murilo999-666/impressora-braille/cad/saida/mesas_250x250/mesa_2.png

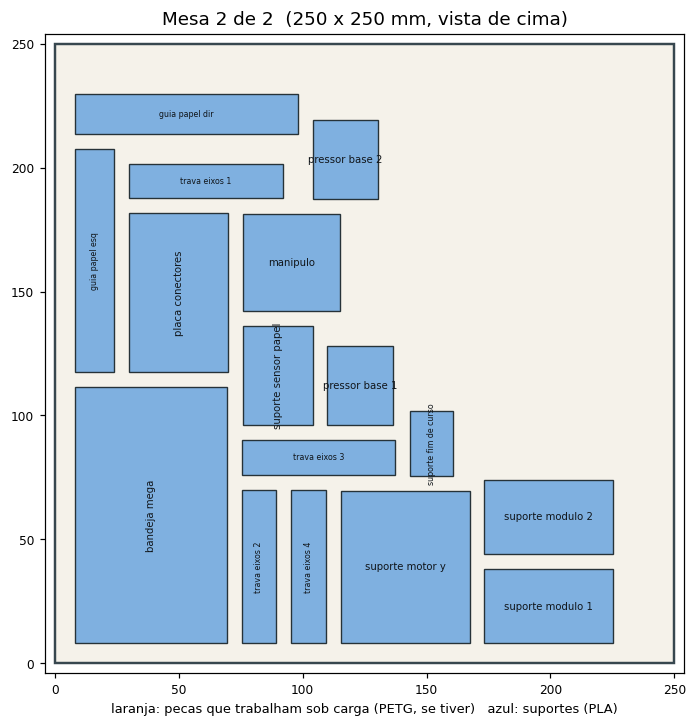
cad/saida/mesas_250x250/mesa_2.png
