murilo999-666/impressora-braille/docs/imagens/aberta_cima.png

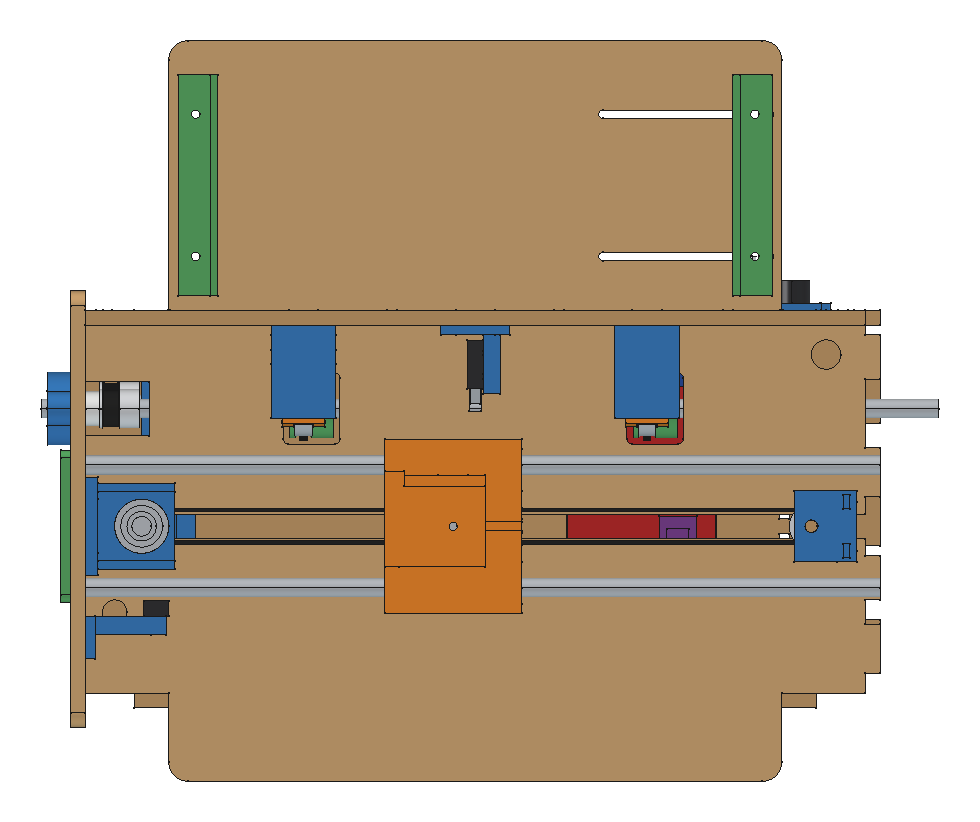
docs/imagens/aberta_cima.png
