murilo999-666/impressora-braille/docs/imagens/aberta_frente.png

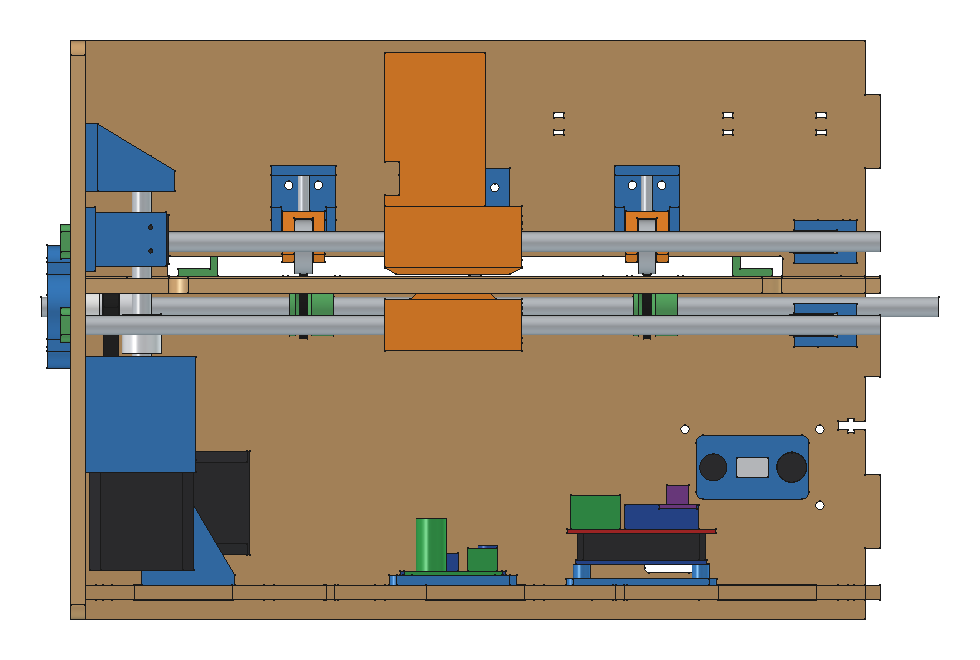
docs/imagens/aberta_frente.png
