murilo999-666/impressora-braille/docs/imagens/aberta_frente_dir.png

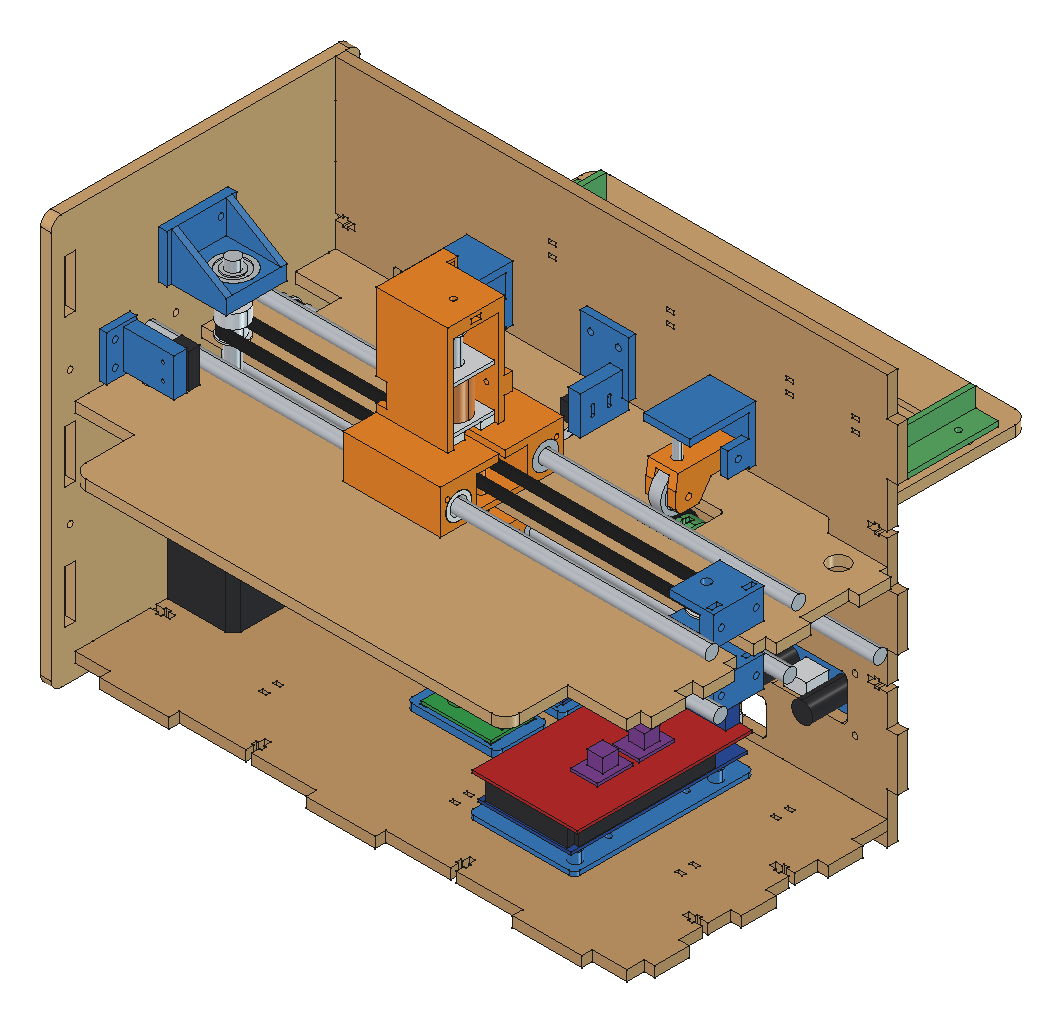
docs/imagens/aberta_frente_dir.png
