murilo999-666/impressora-braille/docs/imagens/carros_frente.png

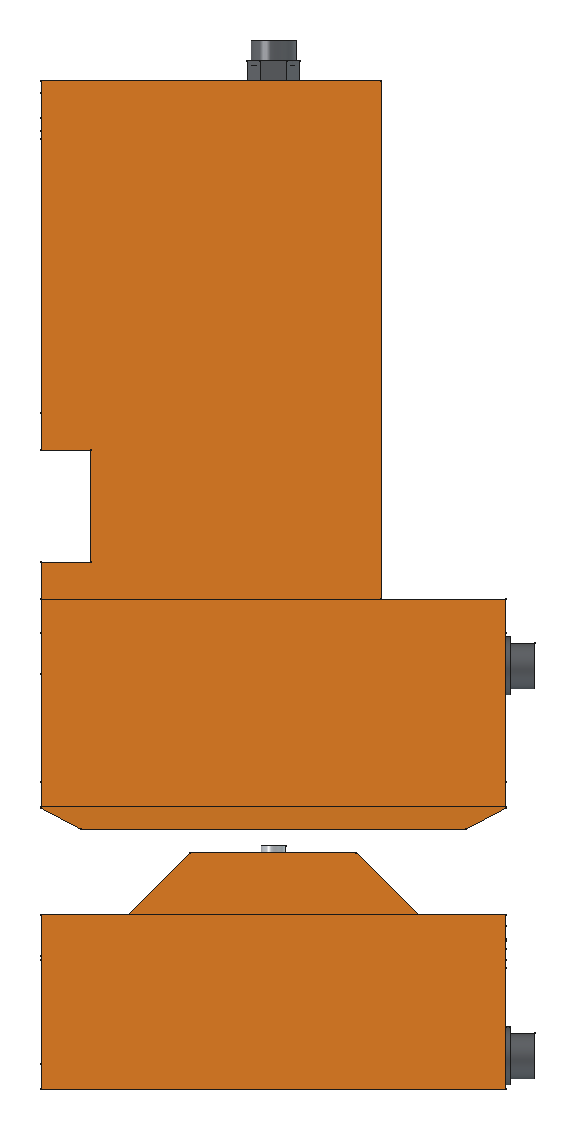
docs/imagens/carros_frente.png
