murilo999-666/impressora-braille/docs/imagens/carros_iso.png

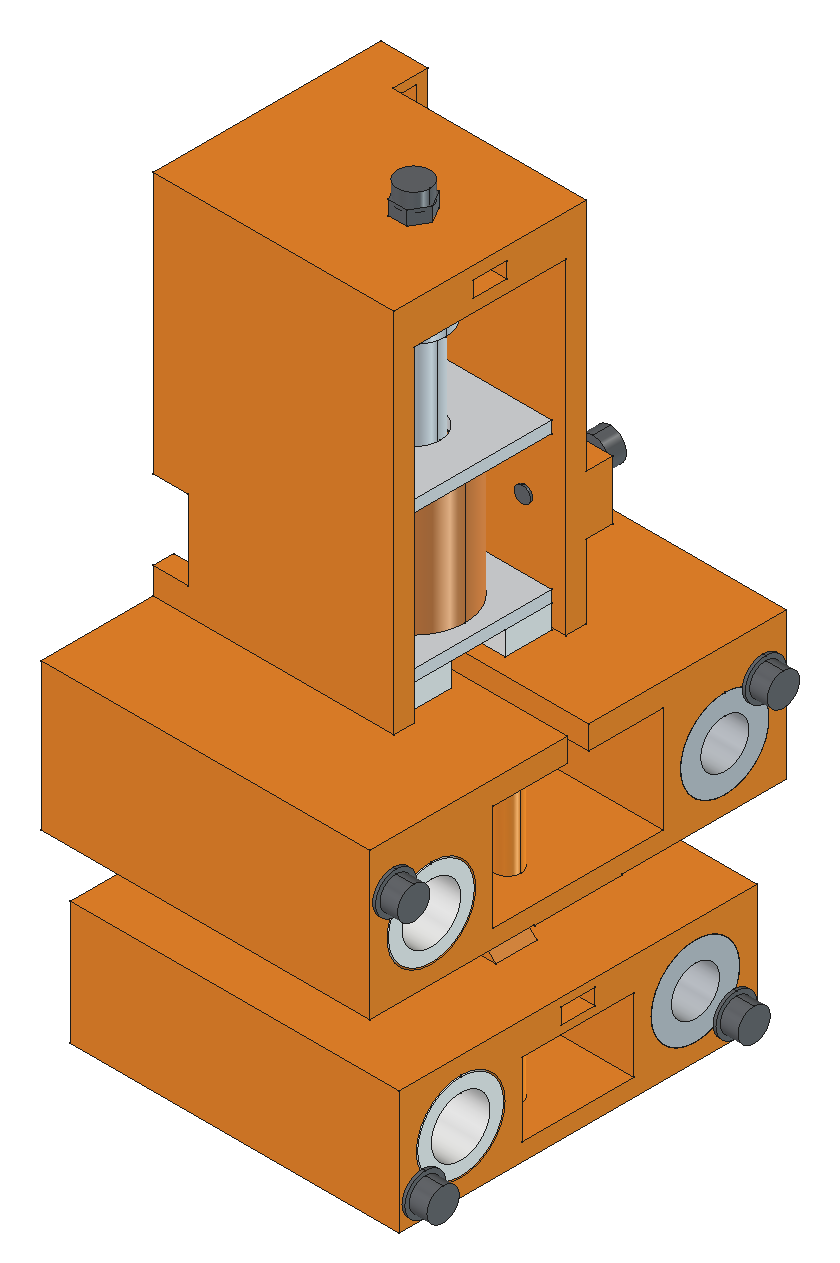
docs/imagens/carros_iso.png
