murilo999-666/impressora-braille/docs/imagens/mecanismo_cima.png

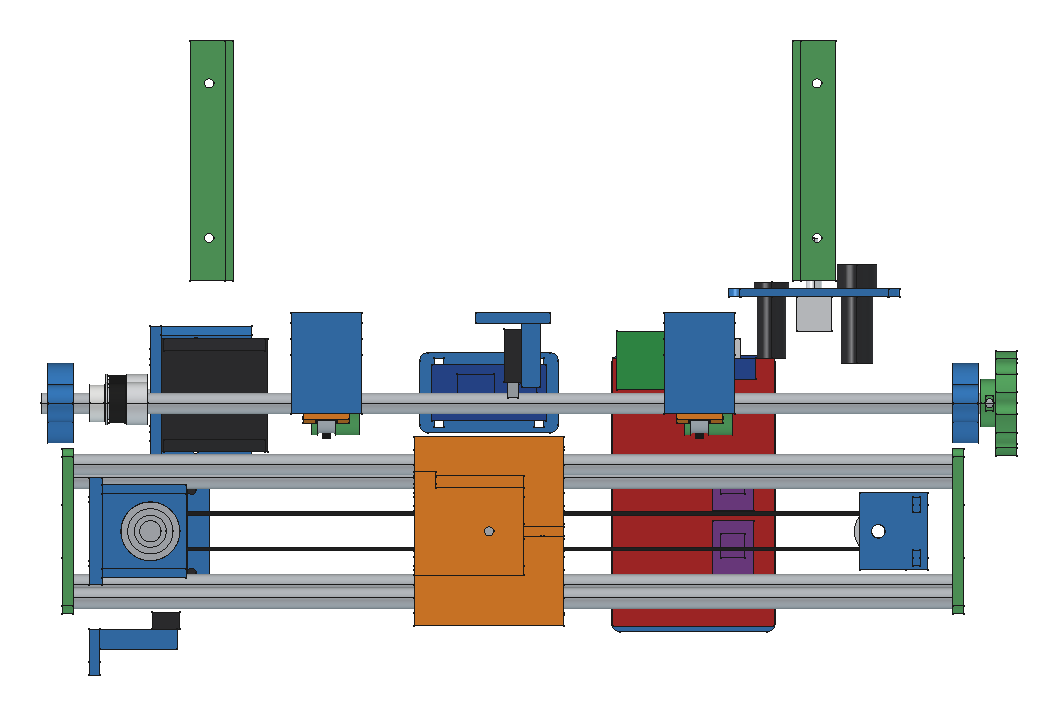
docs/imagens/mecanismo_cima.png
