murilo999-666/impressora-braille/docs/imagens/mecanismo_frente.png

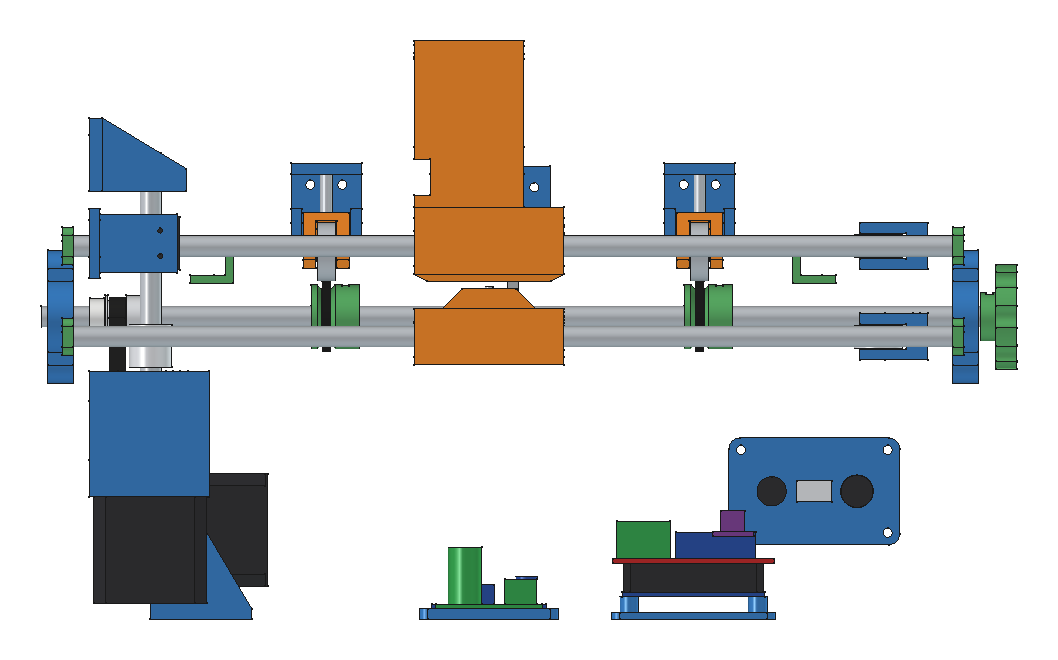
docs/imagens/mecanismo_frente.png
