murilo999-666/impressora-braille/docs/imagens/mecanismo_frente_dir.png

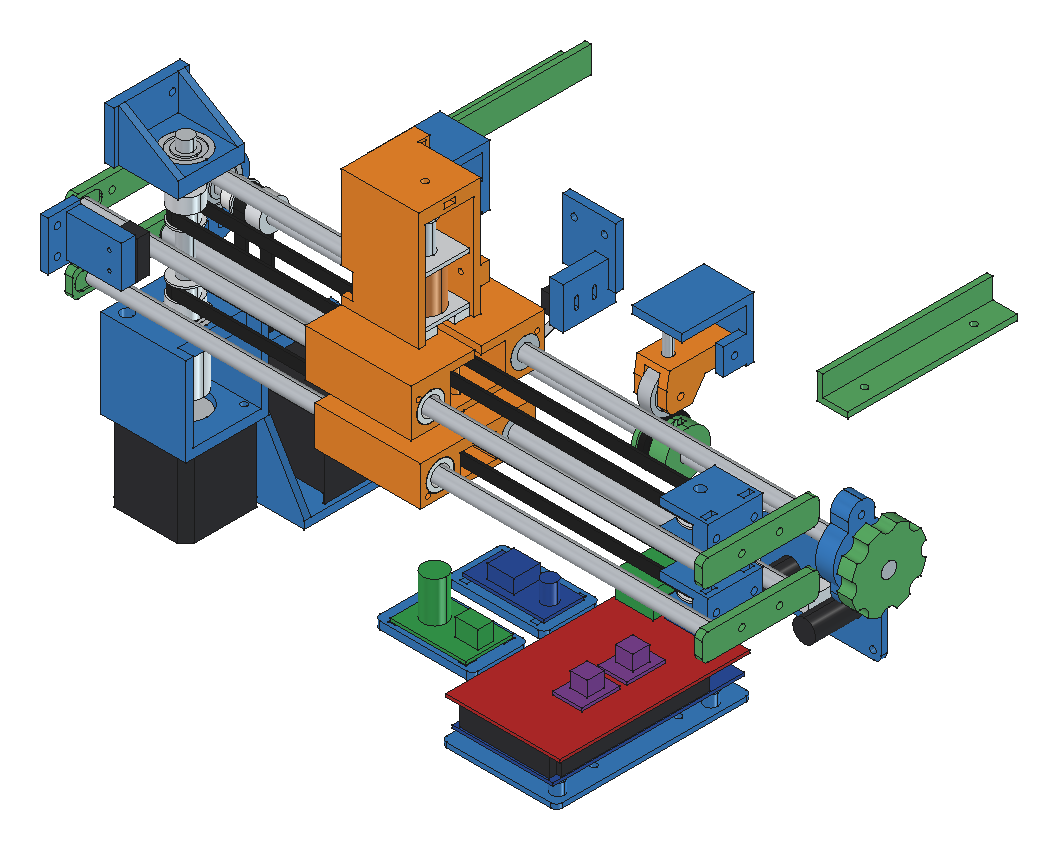
docs/imagens/mecanismo_frente_dir.png
