murilo999-666/impressora-braille/docs/imagens/mecanismo_lado_esquerdo.png

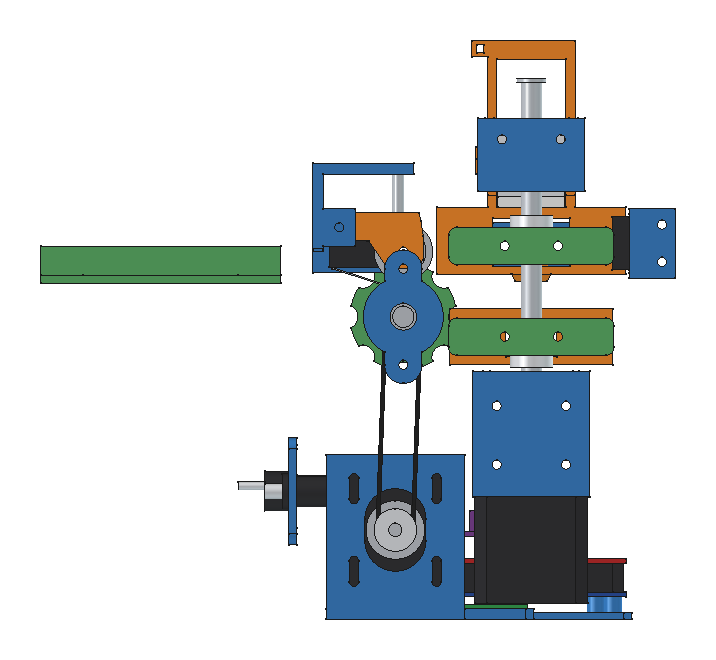
docs/imagens/mecanismo_lado_esquerdo.png
