murilo999-666/impressora-braille/docs/imagens/simulador.png

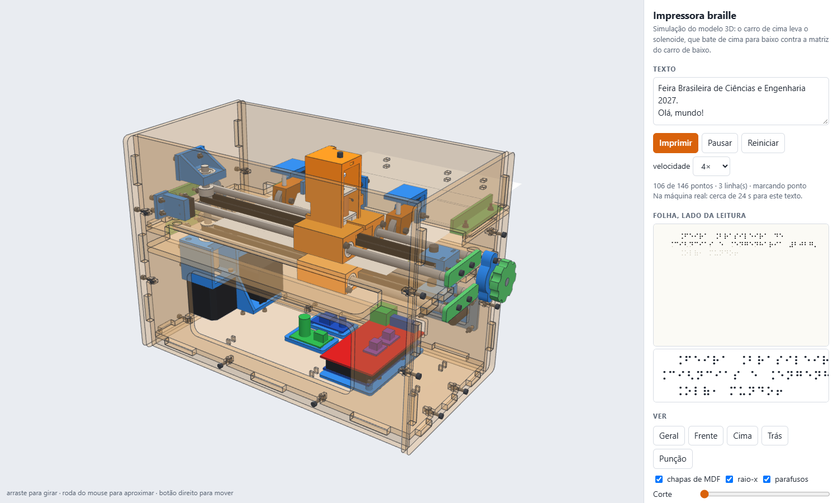
docs/imagens/simulador.png
