murilo999-666/impressora-braille/docs/imagens/simulador_puncao.png

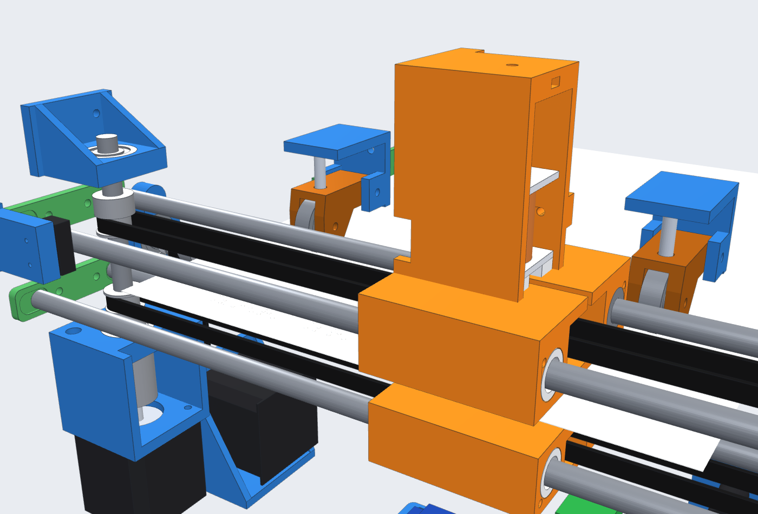
docs/imagens/simulador_puncao.png
