murilo999-666/impressora-braille/cad/impressora_braille.FCStd

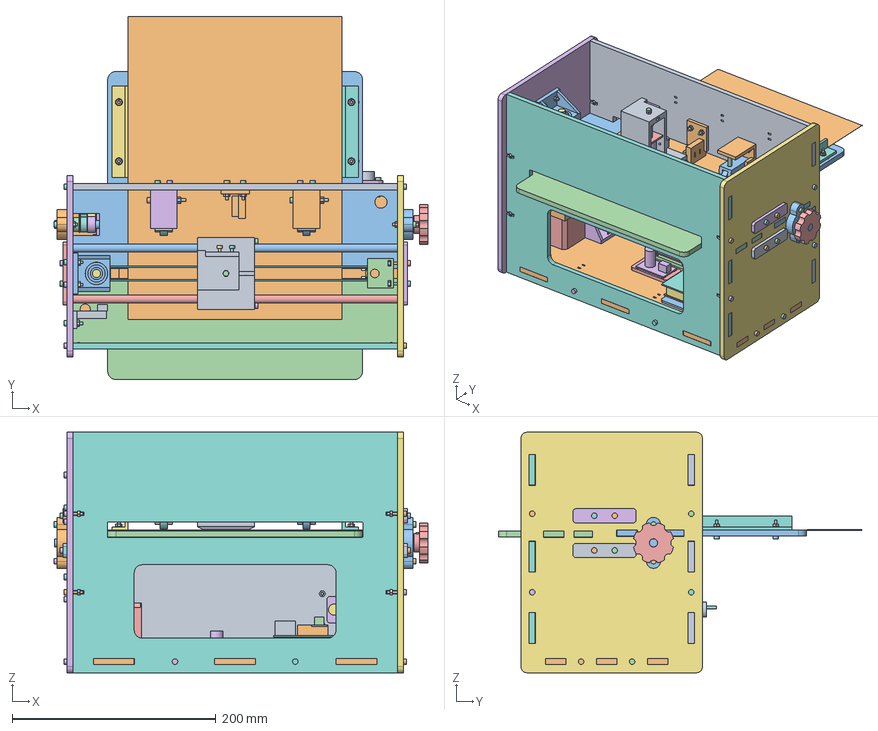
[picture p20: CAD file, 2026-10-13]
cad/impressora_braille.FCStd
366.5 x 356.0 x 236.0 mm
carro_puncao
carro_matriz
espacador_bucha_curto_sup
espacador_bucha_longo_sup_1
espacador_bucha_longo_sup_2
espacador_bucha_curto_inf
espacador_bucha_longo_inf_1
espacador_bucha_longo_inf_2
calco_solenoide
torre_motor_x
mancal_superior
esticador_sup
trava_eixos_sup_esq
trava_eixos_sup_dir
esticador_inf
trava_eixos_inf_esq
trava_eixos_inf_dir
mancal_eixo_papel_esq
mancal_eixo_papel_dir
anel_encosto
rolete_1
pressor_base_1
pressor_braco_1
bucha_608_1
rolete_2
pressor_base_2
pressor_braco_2
bucha_608_2
manipulo
suporte_motor_y
guia_papel_esq
guia_papel_dir
suporte_fim_de_curso
suporte_sensor_papel
bandeja_mega
suporte_stepup
suporte_placa_solenoide
placa_conectores
bucha_lm8uu_sup_1
bucha_lm8uu_sup_2
bucha_lm8uu_sup_3
bucha_lm8uu_inf_1
bucha_lm8uu_inf_2
bucha_lm8uu_inf_3
solenoide_quadro
solenoide_bobina
puncao_estilete
puncao_espacador
solenoide_embolo
matriz_parafuso
eixo_x_sup_tras
eixo_x_inf_tras
eixo_x_sup_frente
eixo_x_inf_frente
eixo_vertical
polia_x_sup
polia_x_inf
rolamento_608_vert_inf
rolamento_608_vert_sup
acoplamento_5x8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
