murilo999-666/impressora-braille/cad/saida/corte_laser/base.dxf

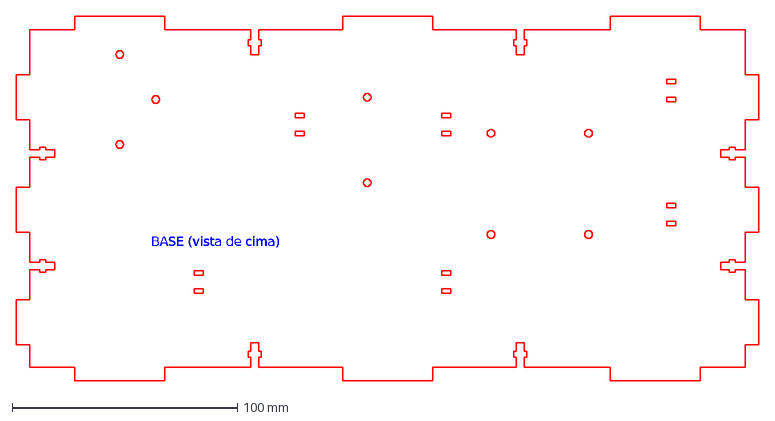
[picture p21: CAD file, 2026-10-13]
cad/saida/corte_laser/base.dxf
BASE (vista de cima)
