murilo999-666/impressora-braille/cad/saida/mesas_250x250/mesa_1.3mf

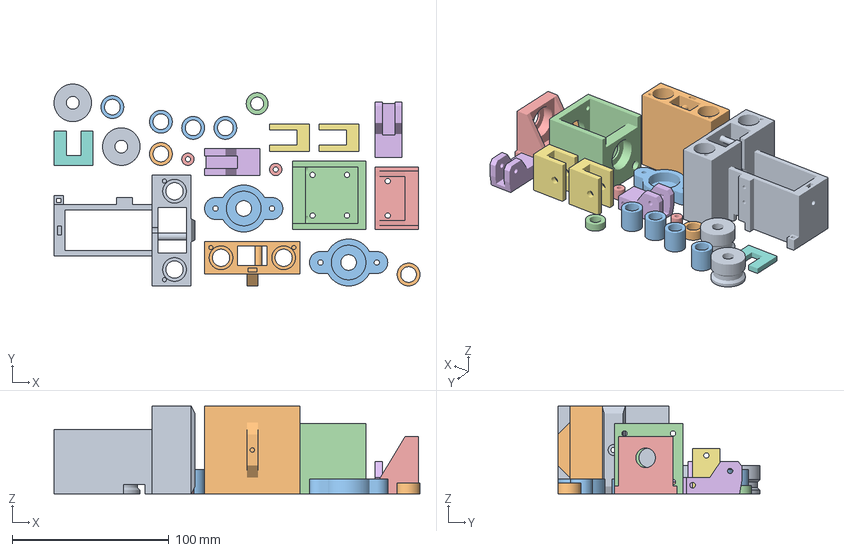
[picture p22: CAD file, 2026-10-13]
cad/saida/mesas_250x250/mesa_1.3mf
233.8 x 129.0 x 56.0 mm
carro_puncao
carro_matriz
mancal_eixo_papel x 2
torre_motor_x
mancal_superior
pressor_braco x 2
esticador x 2
calco_solenoide
rolete x 2
espacador_bucha_curto x 2
espacador_bucha_longo x 4
anel_encosto
bucha_608 x 2
