murilo999-666/impressora-braille/cad/saida/step/bandeja_mega.step

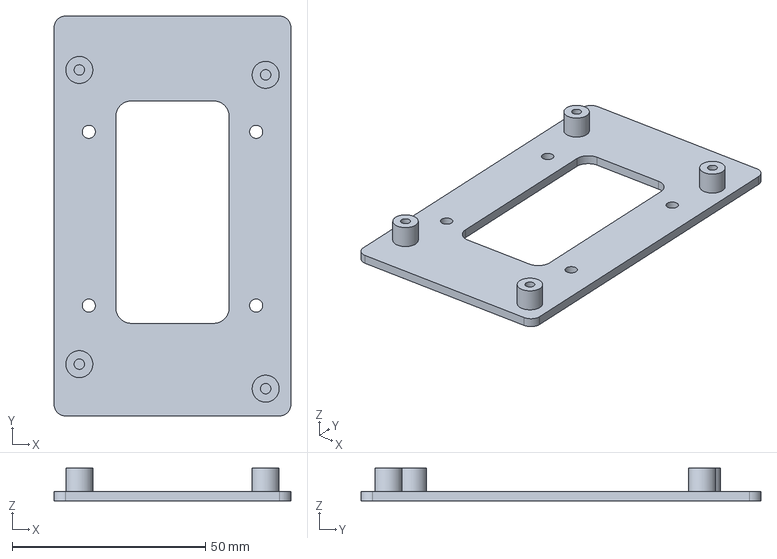
[picture p23: CAD file, 2026-10-13]
cad/saida/step/bandeja_mega.step
61.3 x 103.6 x 8.50 mm
