murilo999-666/impressora-braille/cad/saida/corte_laser/prancha_600x400_1_de_3.dxf

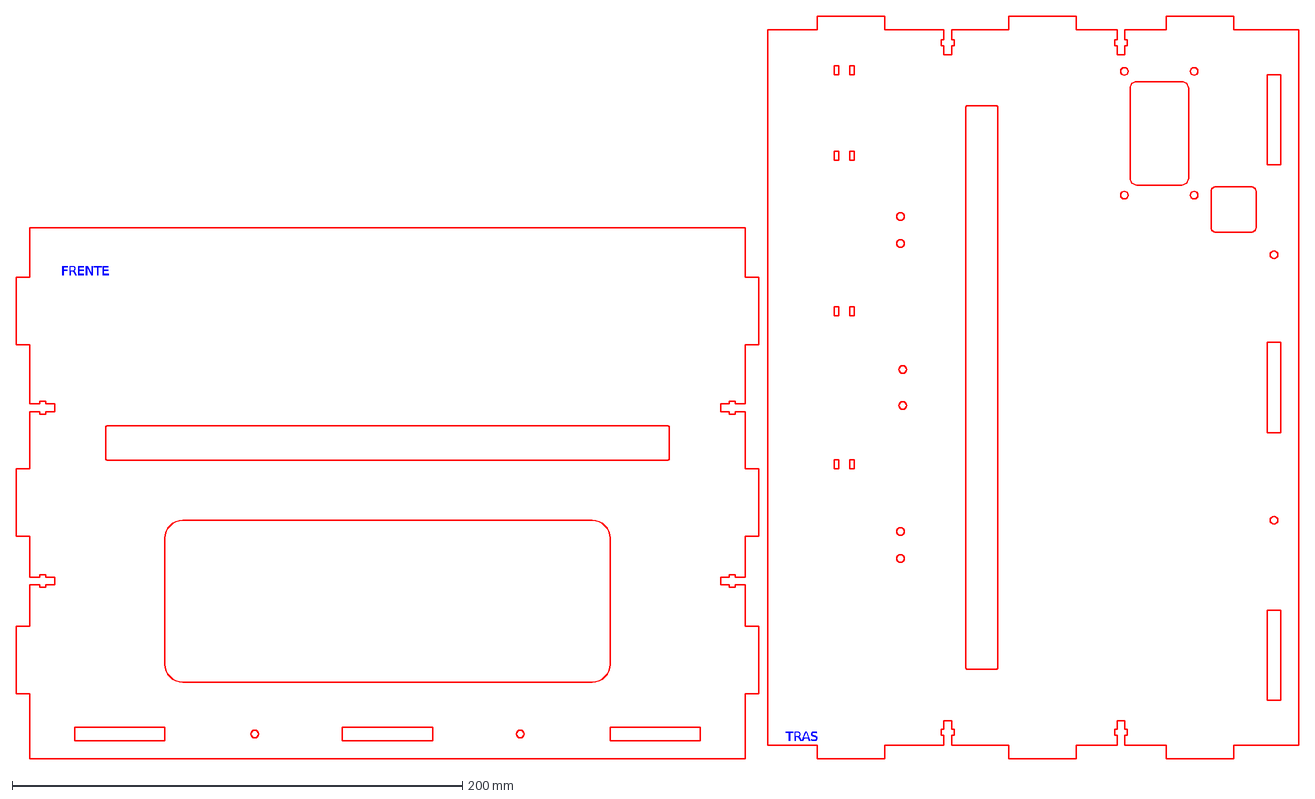
[picture p24: CAD file, 2026-10-13]
cad/saida/corte_laser/prancha_600x400_1_de_3.dxf
FRENTE
TRAS
