murilo999-666/impressora-braille/cad/saida/mesas_250x250/mesa_2.3mf

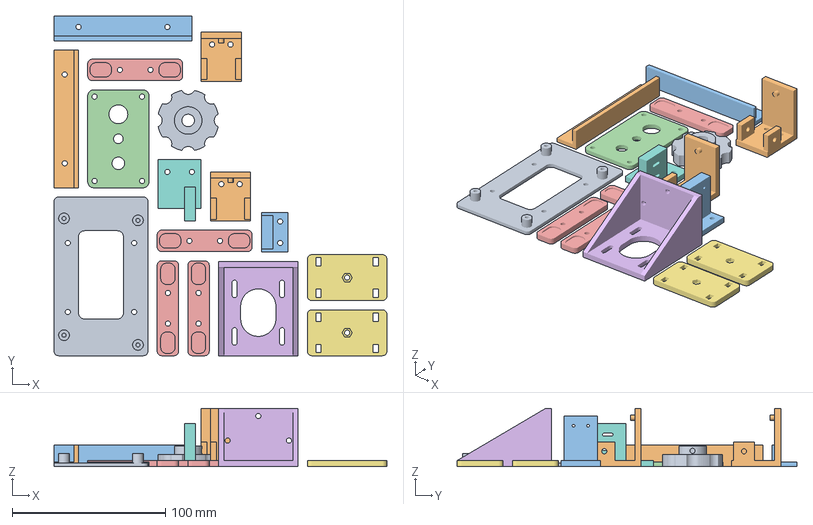
[picture p25: CAD file, 2026-10-13]
cad/saida/mesas_250x250/mesa_2.3mf
217.3 x 221.6 x 38.0 mm
bandeja_mega
guia_papel_esq
guia_papel_dir
placa_conectores
trava_eixos x 4
suporte_motor_y
suporte_modulo x 2
suporte_sensor_papel
manipulo
pressor_base x 2
suporte_fim_de_curso
