murilo999-666/impressora-braille/cad/saida/step/mancal_eixo_papel.step

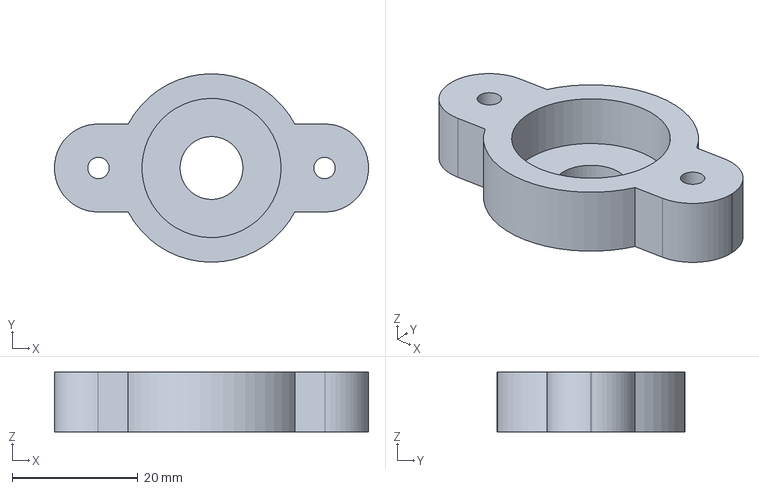
[picture p26: CAD file, 2026-10-13]
cad/saida/step/mancal_eixo_papel.step
50.0 x 30.0 x 9.50 mm
