murilo999-666/impressora-braille/cad/saida/corte_laser/parede_frontal.dxf

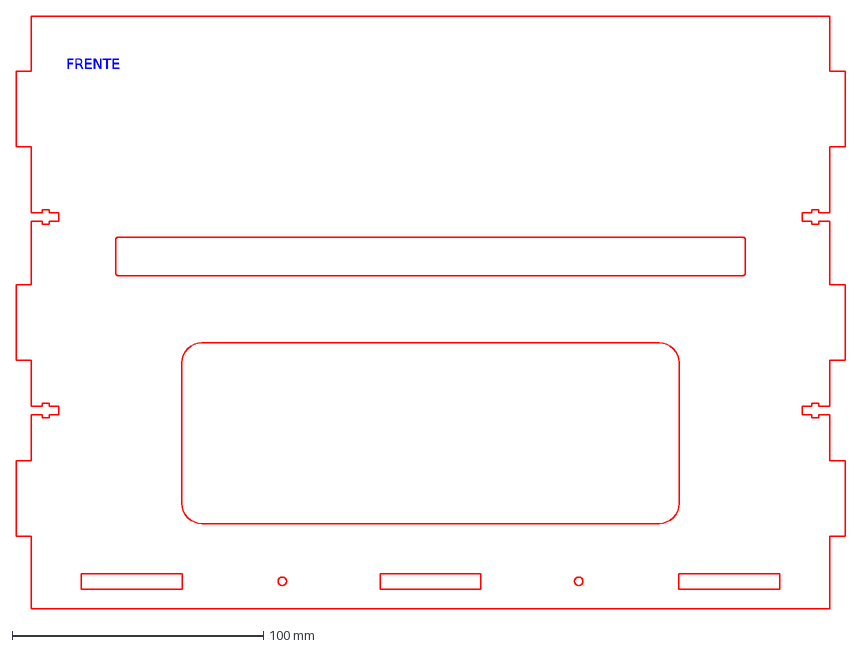
[picture p27: CAD file, 2026-10-13]
cad/saida/corte_laser/parede_frontal.dxf
FRENTE
