murilo999-666/impressora-braille/cad/saida/step/suporte_fim_de_curso.step

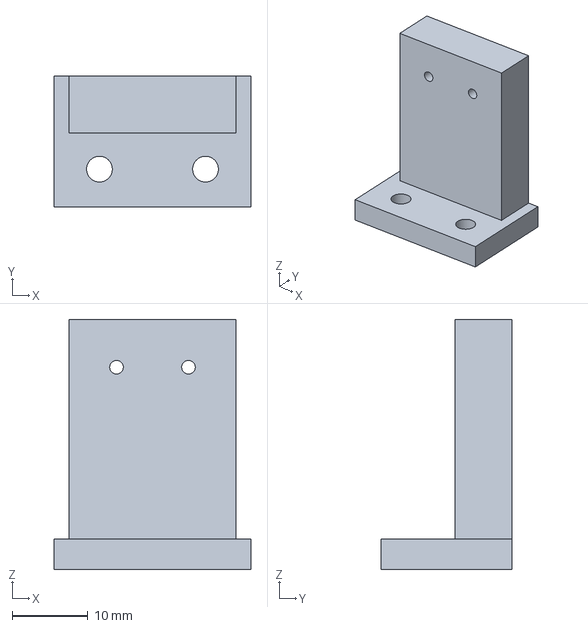
[picture p28: CAD file, 2026-10-13]
cad/saida/step/suporte_fim_de_curso.step
26.0 x 17.3 x 33.0 mm
