murilo999-666/impressora-braille/cad/saida/corte_laser/mesa_traseira.dxf

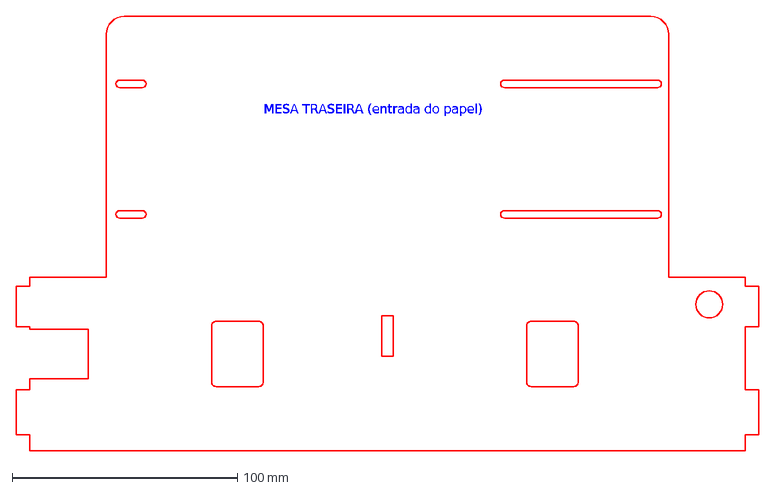
[picture p29: CAD file, 2026-10-13]
cad/saida/corte_laser/mesa_traseira.dxf
MESA TRASEIRA (entrada do papel)
