murilo999-666/impressora-braille/cad/saida/step/espacador_bucha_longo.step

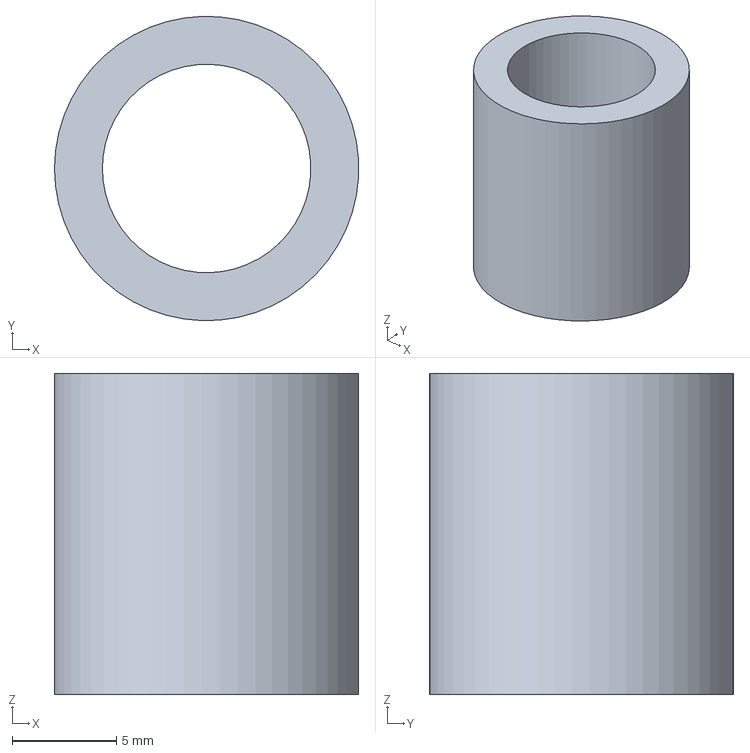
[picture p30: CAD file, 2026-10-13]
cad/saida/step/espacador_bucha_longo.step
14.6 x 14.6 x 15.4 mm
