murilo999-666/impressora-braille/cad/saida/corte_laser/mesa_frontal.dxf

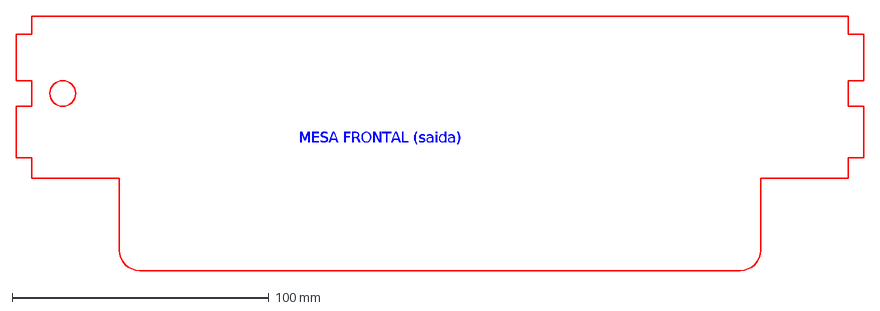
[picture p31: CAD file, 2026-10-13]
cad/saida/corte_laser/mesa_frontal.dxf
MESA FRONTAL (saida)
