murilo999-666/impressora-braille/cad/saida/step/bucha_608.step

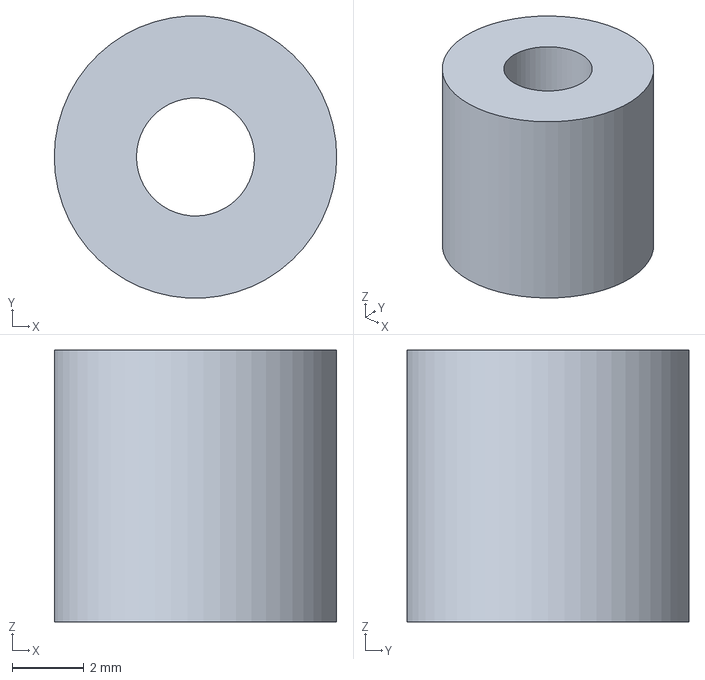
[picture p32: CAD file, 2026-10-13]
cad/saida/step/bucha_608.step
7.90 x 7.89 x 7.60 mm
