murilo999-666/impressora-braille/cad/saida/corte_laser/gabarito_teste.dxf

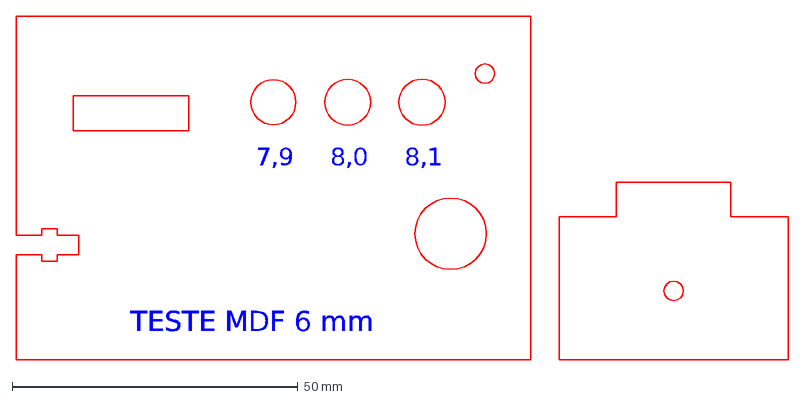
[picture p33: CAD file, 2026-10-13]
cad/saida/corte_laser/gabarito_teste.dxf
7,9
8,0
8,1
TESTE MDF 6 mm
