murilo999-666/impressora-braille/cad/saida/step/espacador_bucha_curto.step

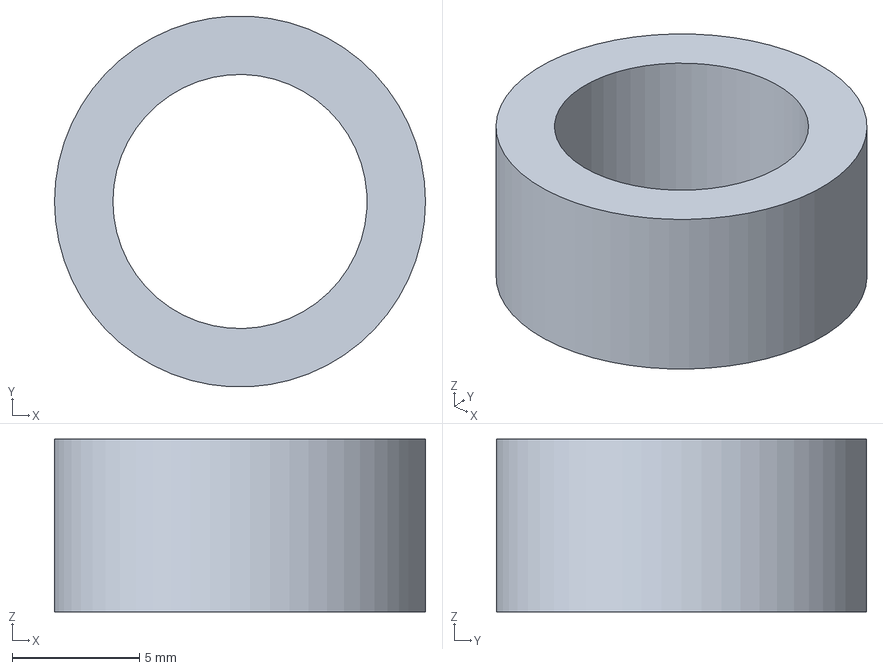
[picture p34: CAD file, 2026-10-13]
cad/saida/step/espacador_bucha_curto.step
14.6 x 14.6 x 6.80 mm
