murilo999-666/impressora-braille/cad/saida/corte_laser/prancha_900x600_2_de_2.dxf

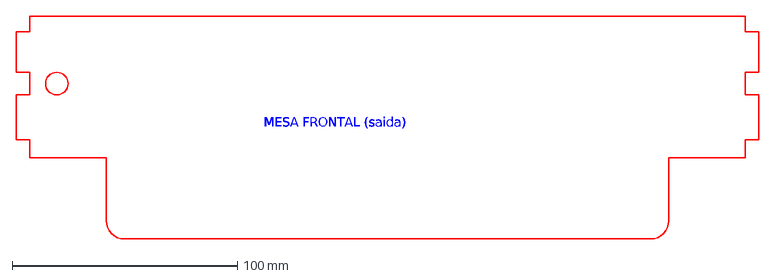
[picture p35: CAD file, 2026-10-13]
cad/saida/corte_laser/prancha_900x600_2_de_2.dxf
MESA FRONTAL (saida)
