murilo999-666/impressora-braille/cad/saida/step/mancal_superior.step

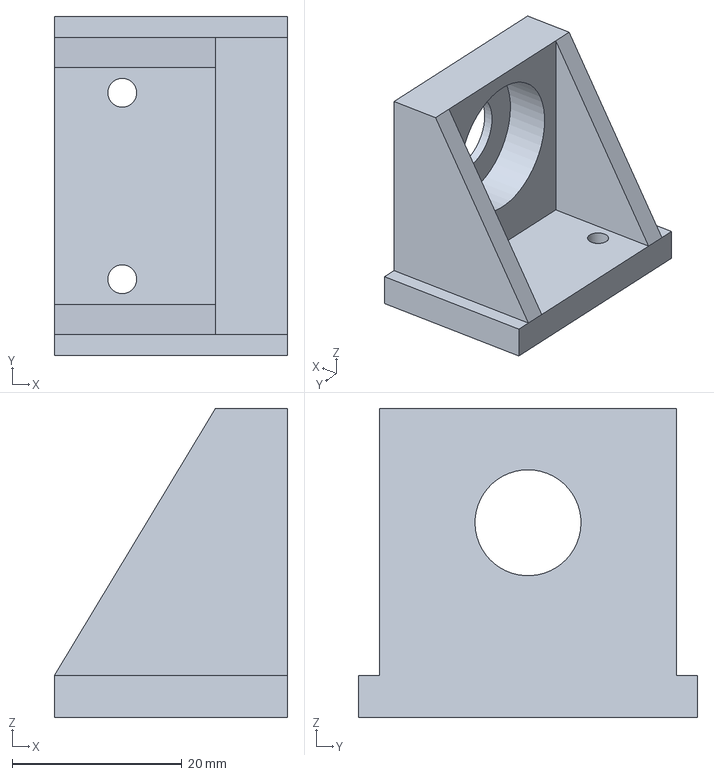
[picture p36: CAD file, 2026-10-13]
cad/saida/step/mancal_superior.step
27.5 x 40.0 x 36.5 mm
