murilo999-666/impressora-braille/cad/saida/corte_laser/prancha_900x600_1_de_2.dxf

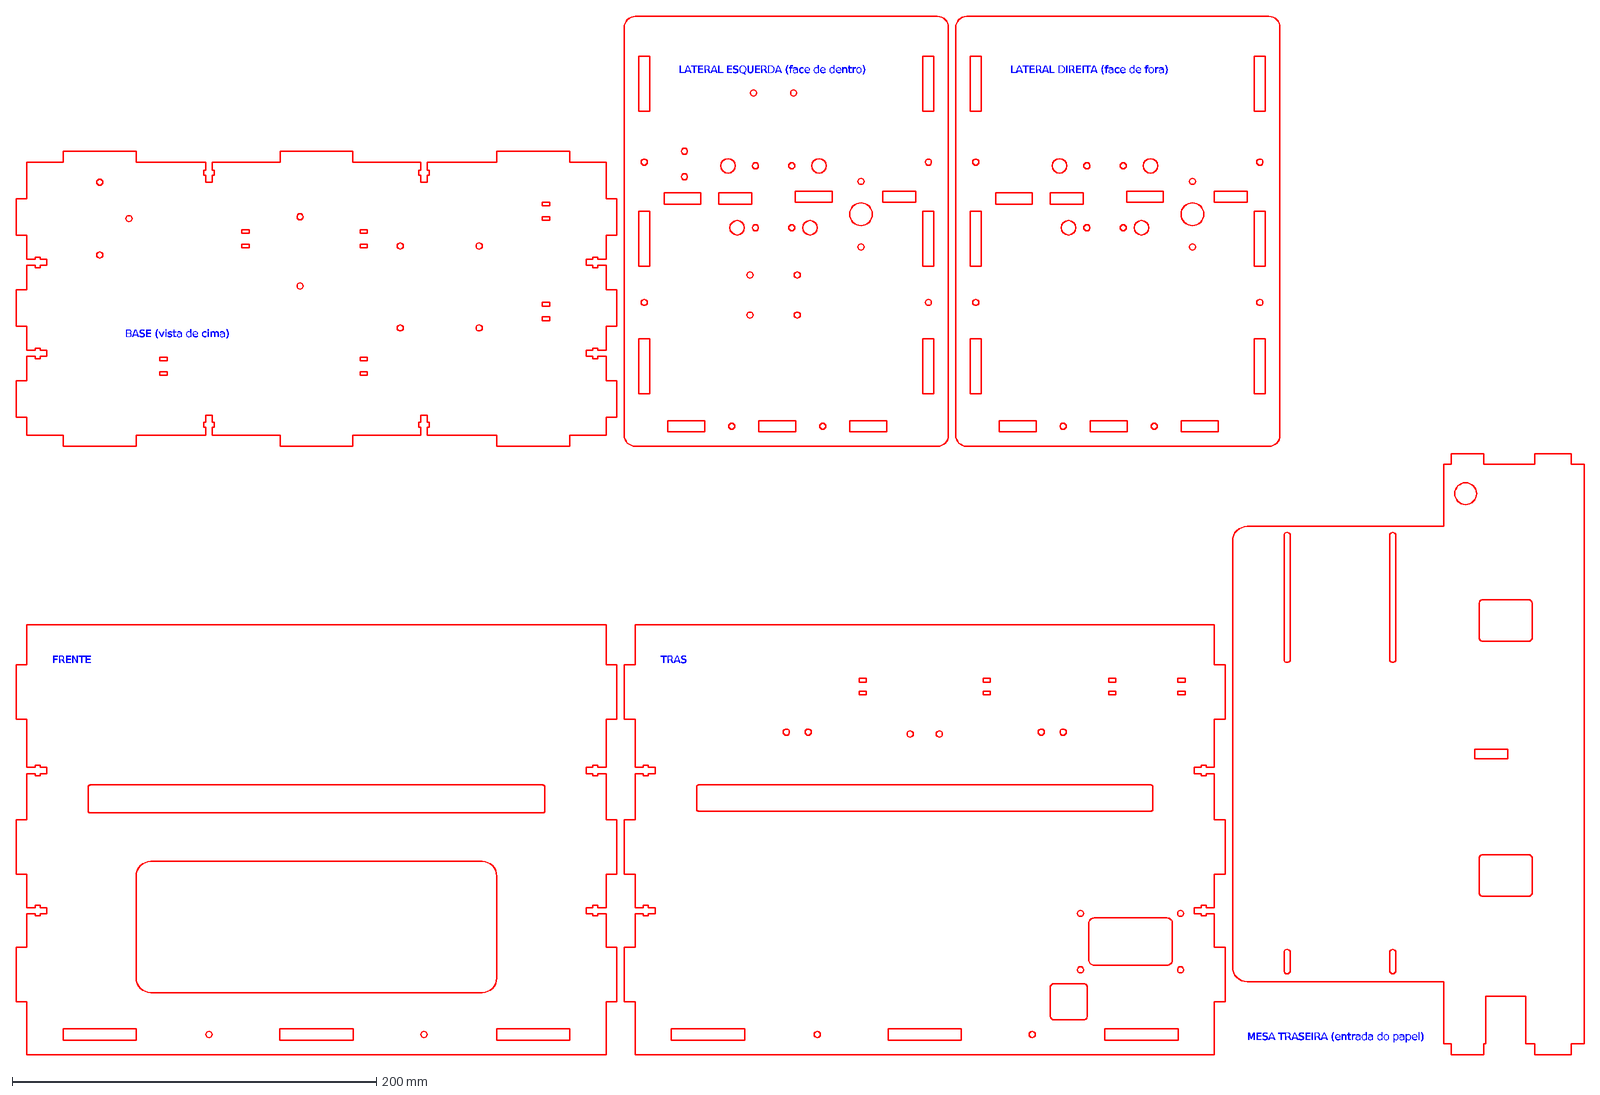
[picture p37: CAD file, 2026-10-13]
cad/saida/corte_laser/prancha_900x600_1_de_2.dxf
FRENTE
TRAS
MESA TRASEIRA (entrada do papel)
BASE (vista de cima)
LATERAL ESQUERDA (face de dentro)
LATERAL DIREITA (face de fora)
