murilo999-666/impressora-braille/cad/saida/step/trava_eixos.step

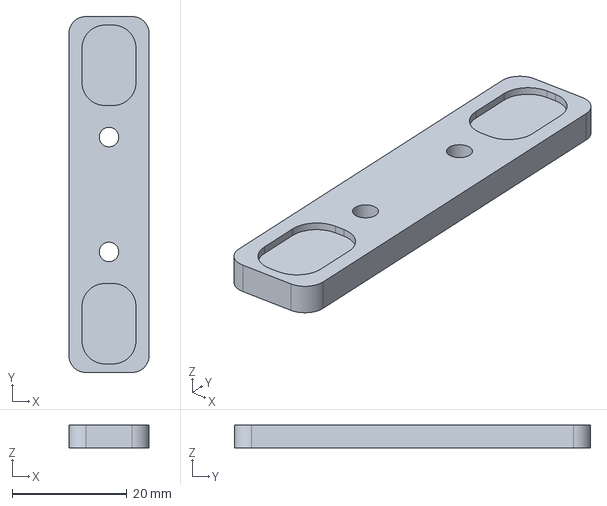
[picture p38: CAD file, 2026-10-13]
cad/saida/step/trava_eixos.step
14.0 x 62.0 x 4.00 mm
