murilo999-666/impressora-braille/cad/saida/corte_laser/lateral_direita.dxf

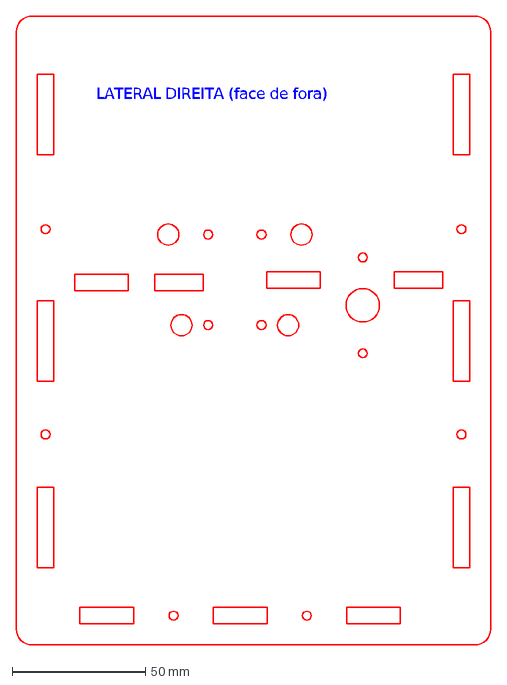
[picture p39: CAD file, 2026-10-13]
cad/saida/corte_laser/lateral_direita.dxf
LATERAL DIREITA (face de fora)
