murilo999-666/impressora-braille/cad/saida/step/suporte_motor_y.step

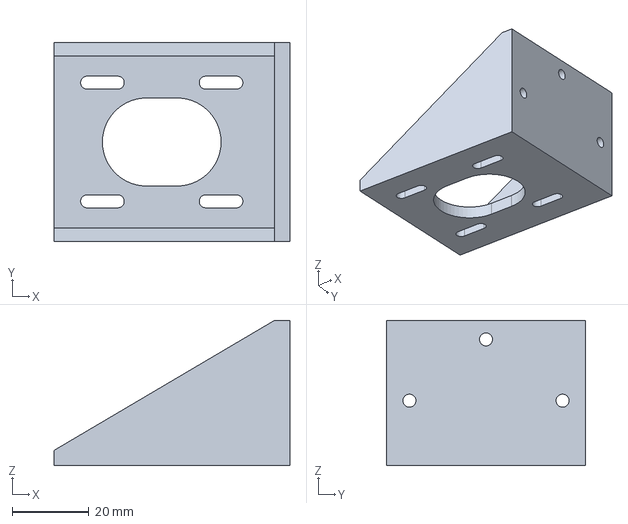
[picture p40: CAD file, 2026-10-13]
cad/saida/step/suporte_motor_y.step
61.7 x 52.0 x 38.0 mm
