murilo999-666/impressora-braille/cad/saida/corte_laser/parede_traseira.dxf

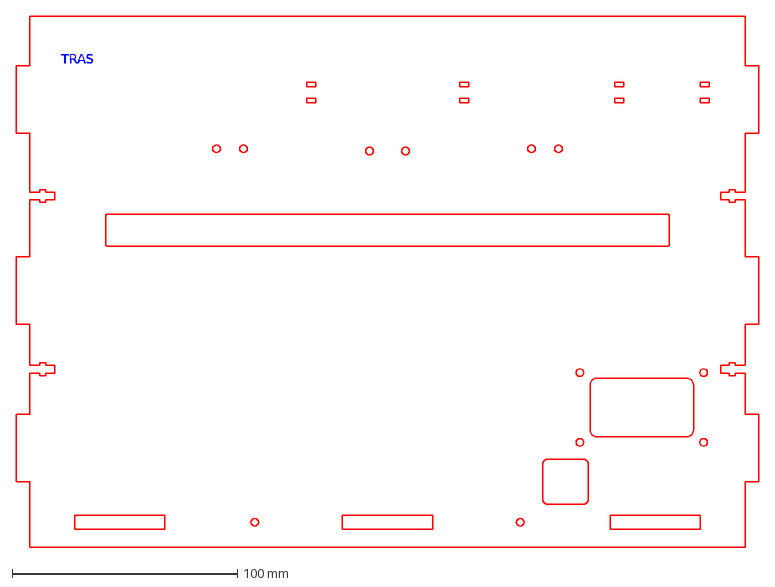
[picture p41: CAD file, 2026-10-13]
cad/saida/corte_laser/parede_traseira.dxf
TRAS
