murilo999-666/impressora-braille/cad/saida/step/carro_matriz.step

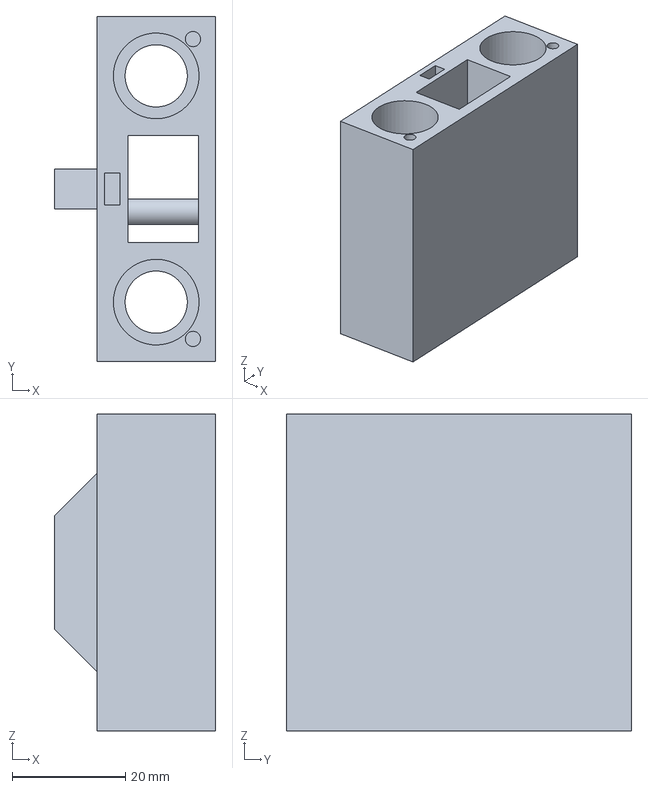
[picture p42: CAD file, 2026-10-13]
cad/saida/step/carro_matriz.step
28.5 x 61.0 x 56.0 mm
