murilo999-666/impressora-braille/cad/saida/corte_laser/prancha_600x400_3_de_3.dxf

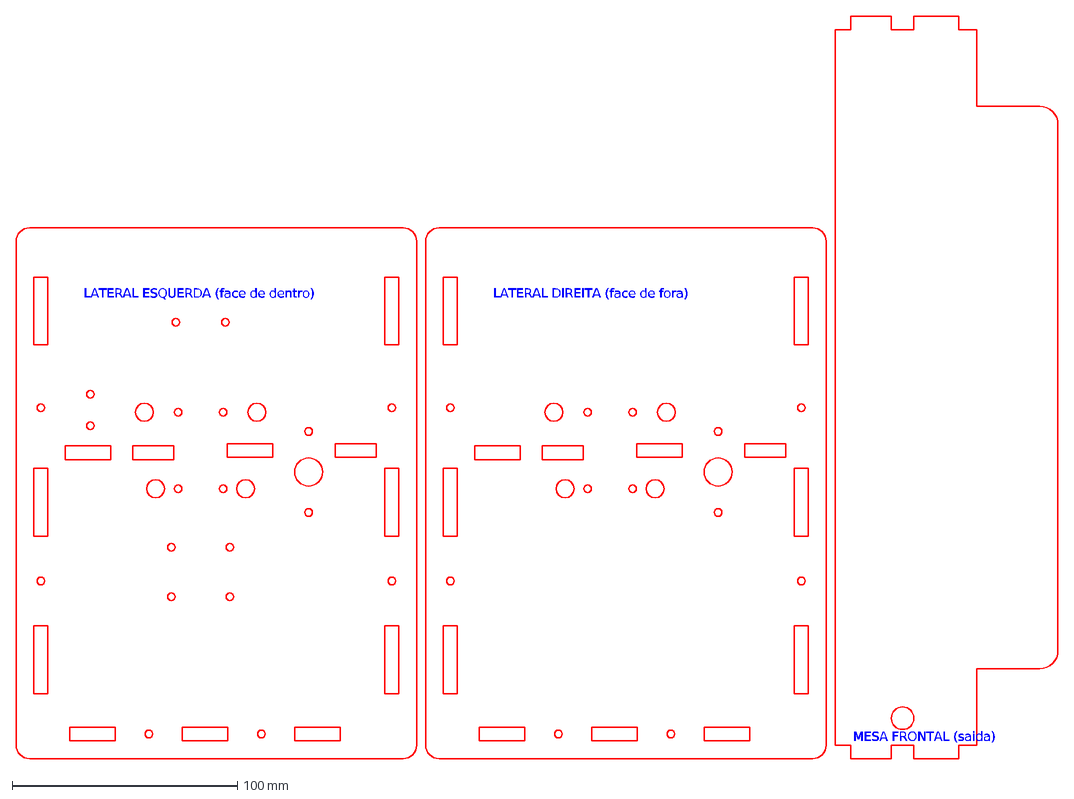
[picture p43: CAD file, 2026-10-13]
cad/saida/corte_laser/prancha_600x400_3_de_3.dxf
LATERAL ESQUERDA (face de dentro)
LATERAL DIREITA (face de fora)
MESA FRONTAL (saida)
