murilo999-666/impressora-braille/cad/saida/step/guia_papel_dir.step

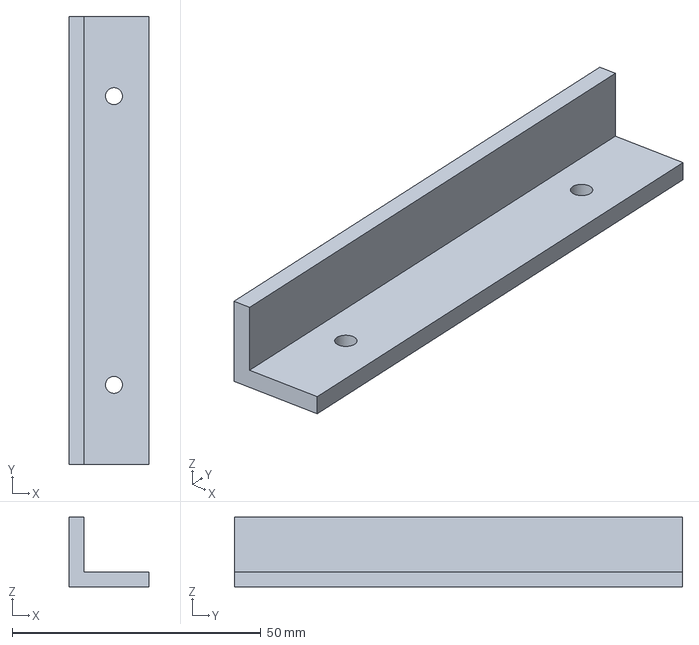
[picture p44: CAD file, 2026-10-13]
cad/saida/step/guia_papel_dir.step
16.0 x 90.0 x 14.0 mm
