murilo999-666/impressora-braille/cad/saida/corte_laser/lateral_esquerda.dxf

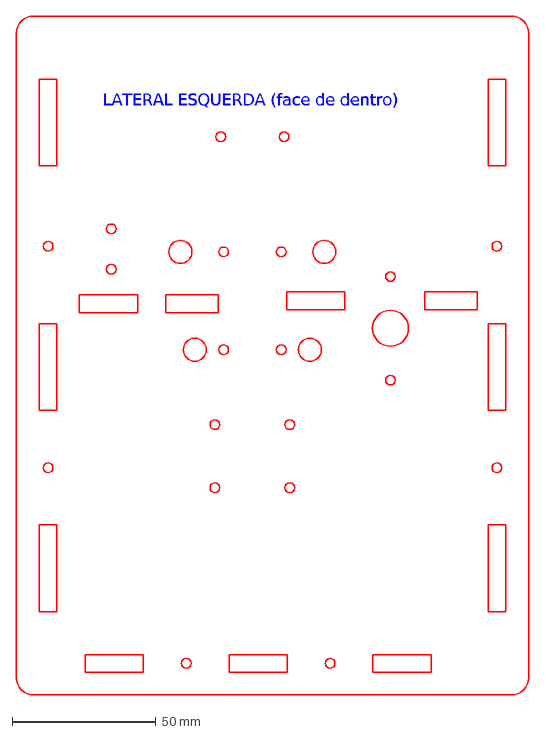
[picture p45: CAD file, 2026-10-13]
cad/saida/corte_laser/lateral_esquerda.dxf
LATERAL ESQUERDA (face de dentro)
