murilo999-666/impressora-braille/cad/saida/step/torre_motor_x.step

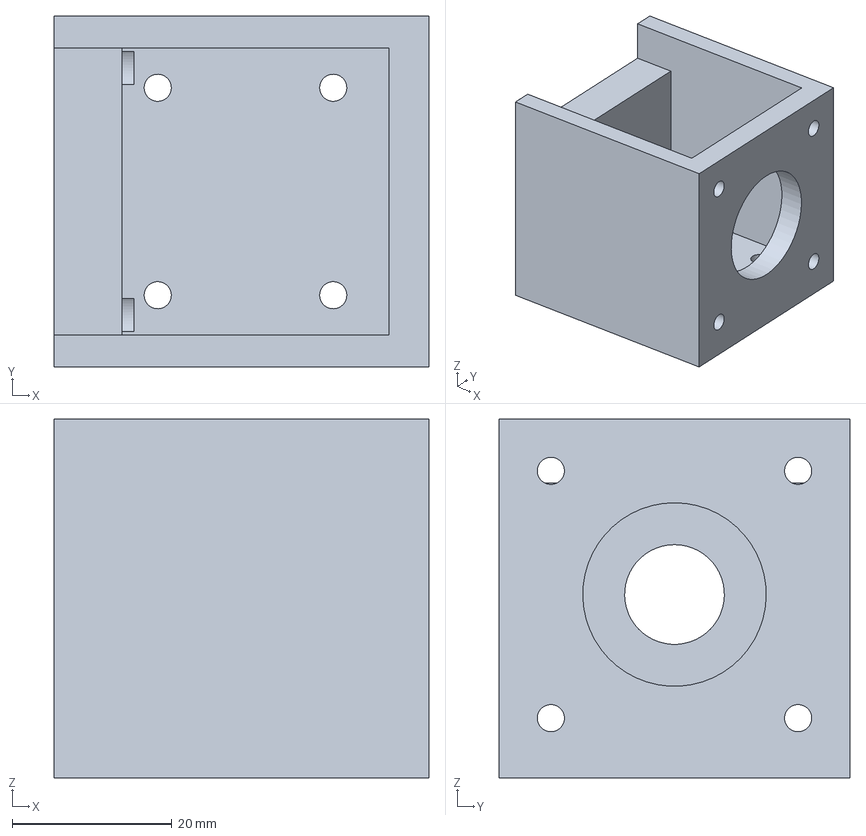
[picture p46: CAD file, 2026-10-13]
cad/saida/step/torre_motor_x.step
47.0 x 44.0 x 45.0 mm
