murilo999-666/impressora-braille/cad/saida/corte_laser/prancha_600x400_2_de_3.dxf

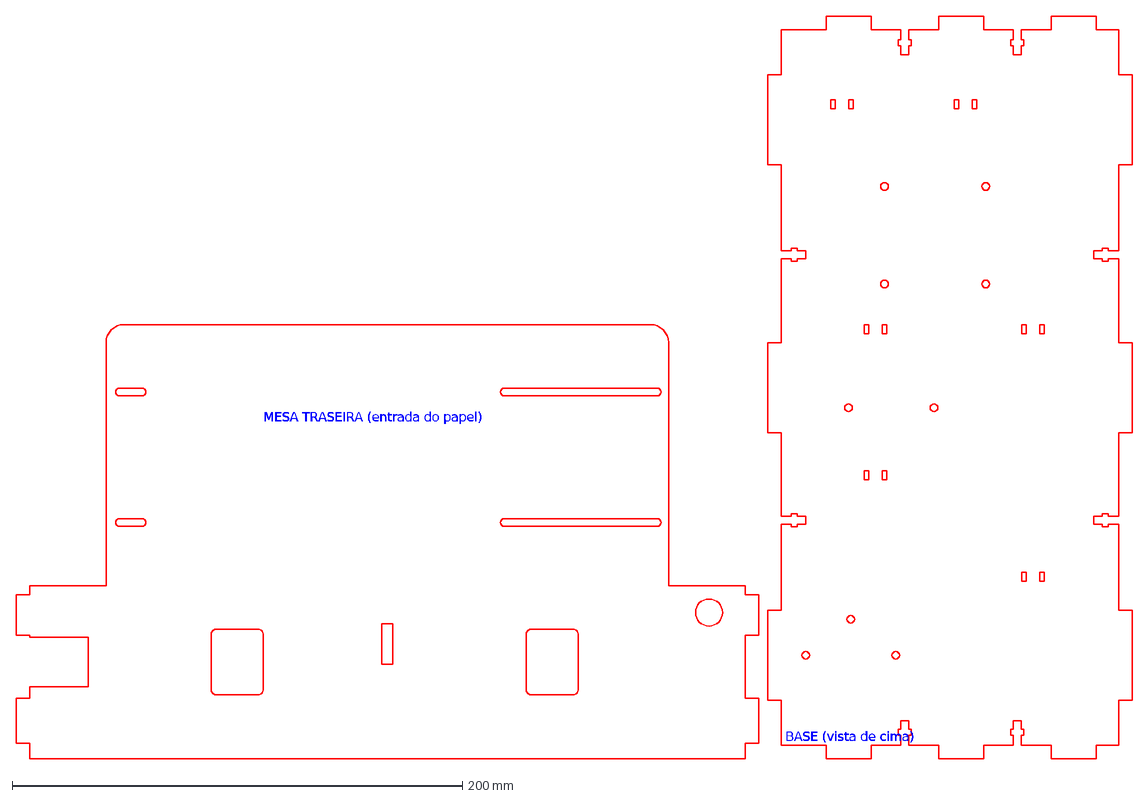
[picture p47: CAD file, 2026-10-13]
cad/saida/corte_laser/prancha_600x400_2_de_3.dxf
MESA TRASEIRA (entrada do papel)
BASE (vista de cima)
