murilo999-666/impressora-braille/cad/saida/step/calco_solenoide.step

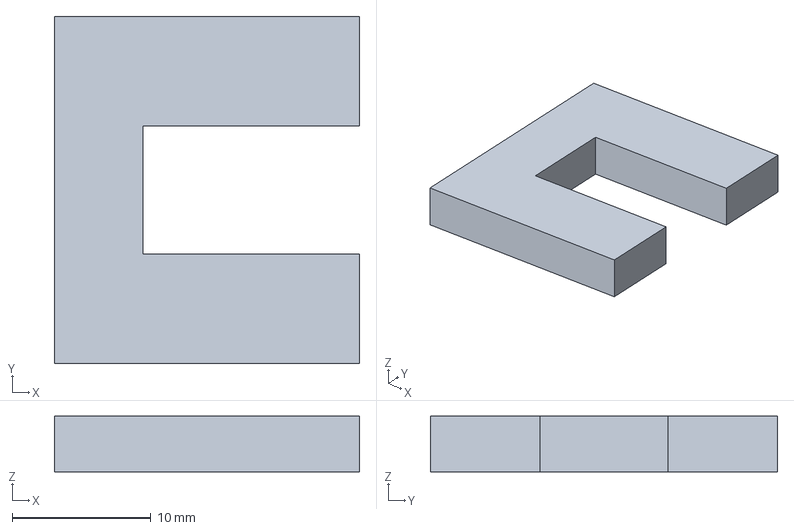
[picture p48: CAD file, 2026-10-13]
cad/saida/step/calco_solenoide.step
22.0 x 25.0 x 4.00 mm
