murilo999-666/impressora-braille/cad/saida/step/rolete.step

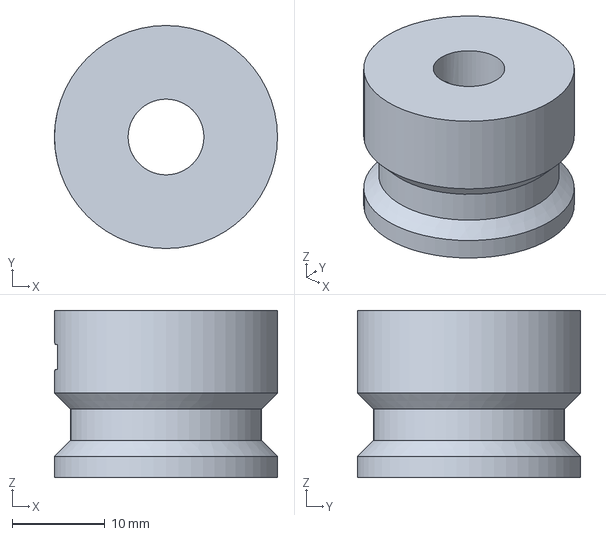
[picture p49: CAD file, 2026-10-13]
cad/saida/step/rolete.step
24.0 x 24.0 x 18.0 mm
