murilo999-666/impressora-braille/cad/saida/step/suporte_modulo.step

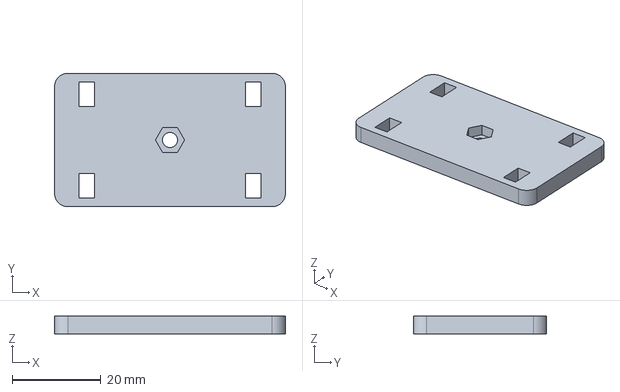
[picture p50: CAD file, 2026-10-13]
cad/saida/step/suporte_modulo.step
52.0 x 30.0 x 4.00 mm
