murilo999-666/impressora-braille/cad/saida/step/suporte_sensor_papel.step

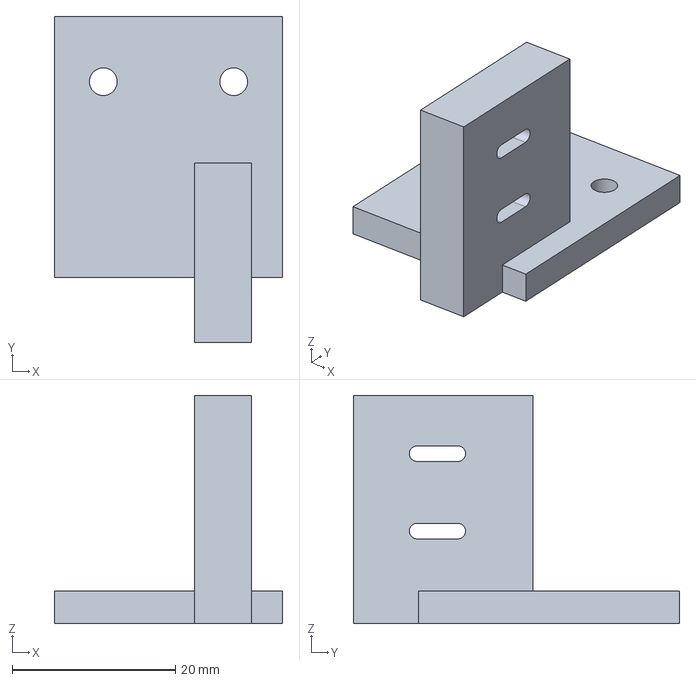
[picture p51: CAD file, 2026-10-13]
cad/saida/step/suporte_sensor_papel.step
28.0 x 40.0 x 28.0 mm
