murilo999-666/impressora-braille/cad/saida/step/manipulo.step

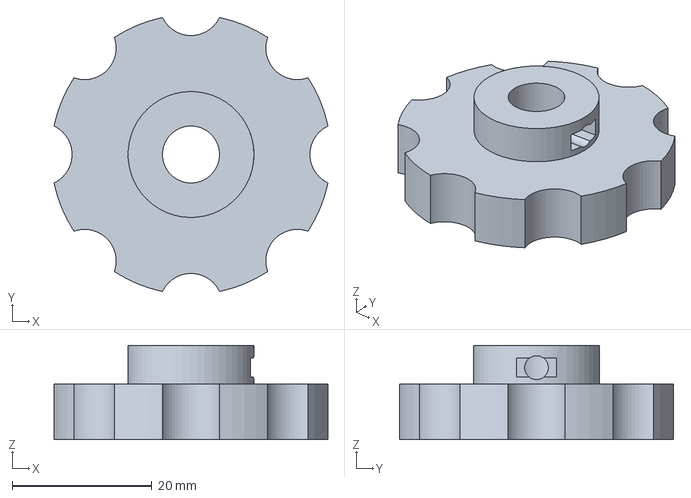
[picture p52: CAD file, 2026-10-13]
cad/saida/step/manipulo.step
39.2 x 39.2 x 13.5 mm
