murilo999-666/impressora-braille/cad/saida/step/pressor_base.step

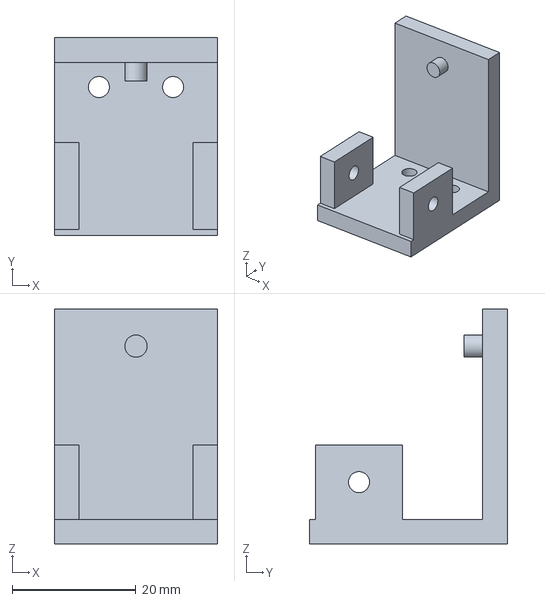
[picture p53: CAD file, 2026-10-13]
cad/saida/step/pressor_base.step
26.4 x 32.0 x 38.0 mm
