murilo999-666/impressora-braille/cad/saida/step/anel_encosto.step

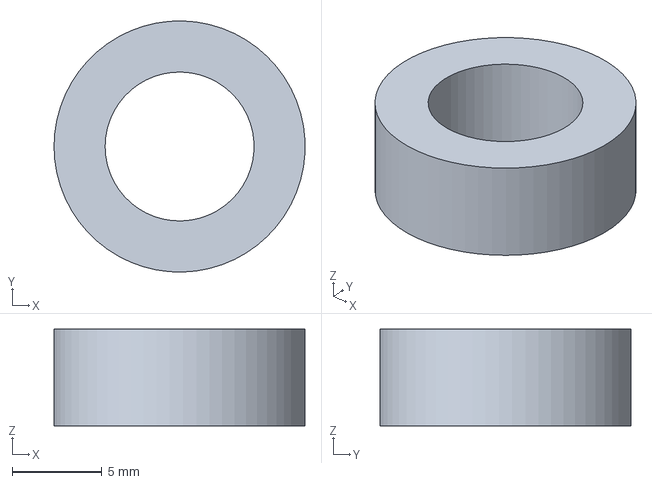
[picture p54: CAD file, 2026-10-13]
cad/saida/step/anel_encosto.step
14.0 x 14.0 x 5.40 mm
