murilo999-666/impressora-braille/cad/saida/step/placa_conectores.step

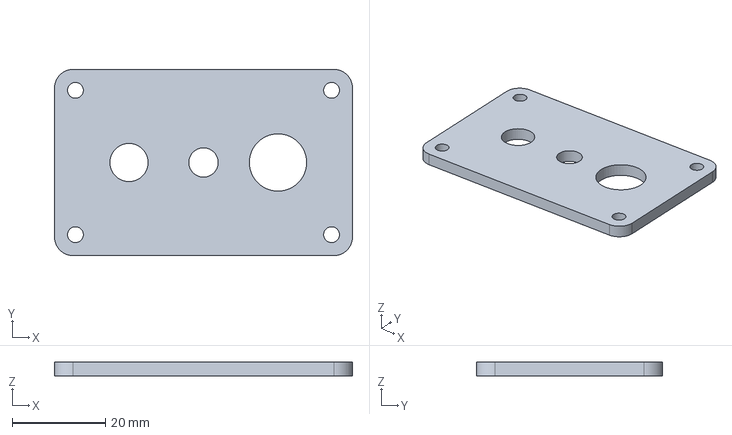
[picture p55: CAD file, 2026-10-13]
cad/saida/step/placa_conectores.step
64.0 x 40.0 x 3.00 mm
