murilo999-666/impressora-braille/cad/saida/step/pressor_braco.step

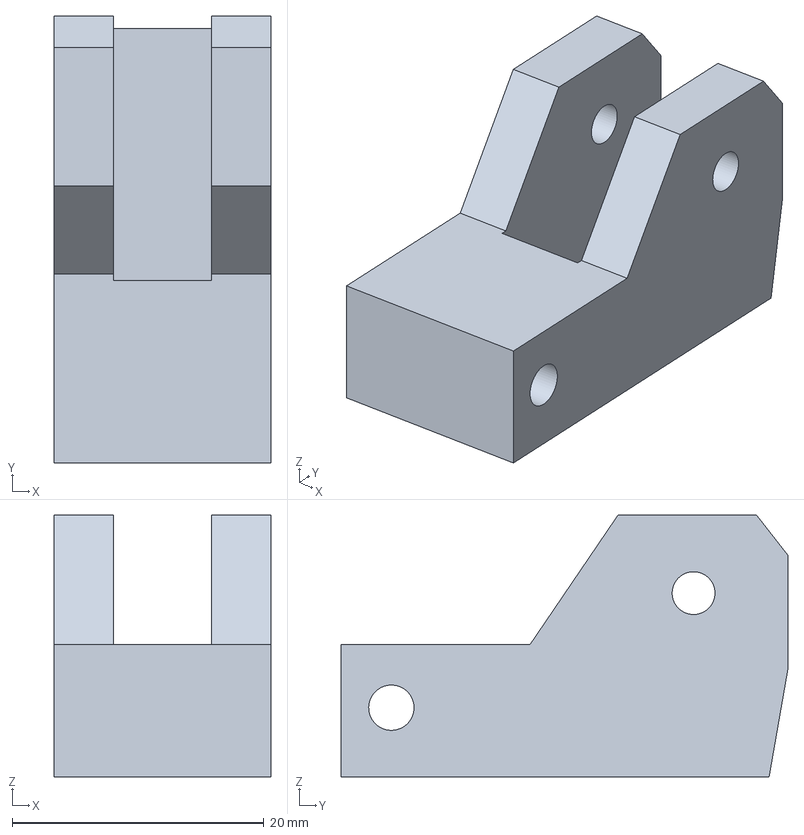
[picture p56: CAD file, 2026-10-13]
cad/saida/step/pressor_braco.step
17.2 x 35.5 x 20.8 mm
