murilo999-666/impressora-braille/cad/saida/step/esticador.step

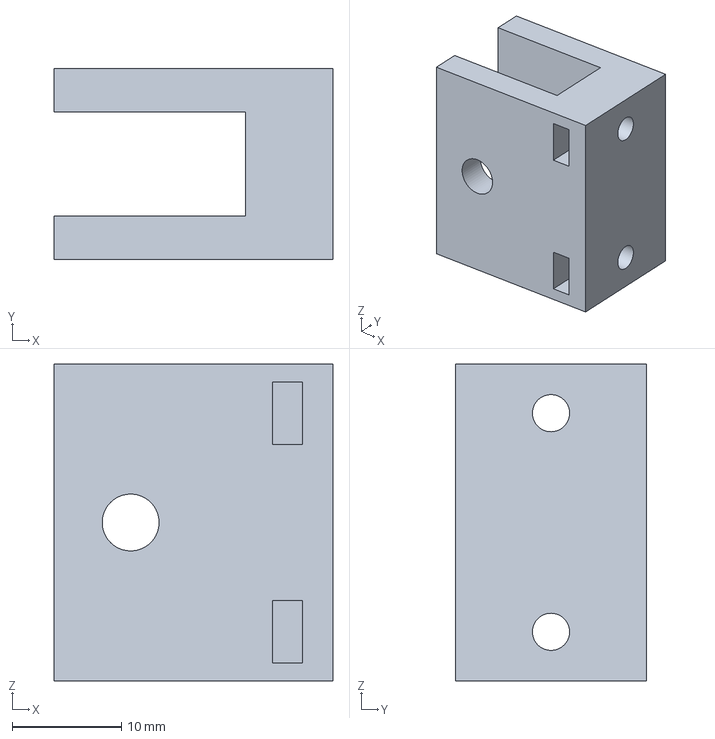
[picture p57: CAD file, 2026-10-13]
cad/saida/step/esticador.step
25.5 x 17.5 x 29.0 mm
