murilo999-666/impressora-braille/cad/saida/step/carro_puncao.step

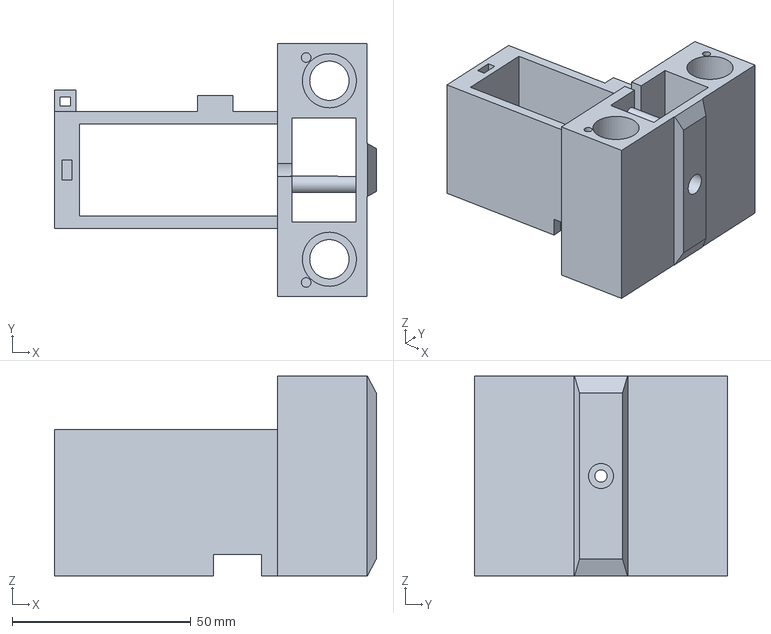
[picture p58: CAD file, 2026-10-13]
cad/saida/step/carro_puncao.step
90.2 x 71.0 x 56.0 mm
