murilo999-666/impressora-braille/(list of files, cad)

Other CAD files:
cad/saida/step/montagem_completa.step
cad/saida/step/guia_papel_esq.step
cad/saida/mesas_250x250/mesa_1.stl
cad/saida/mesas_250x250/mesa_2.stl
cad/saida/stl/anel_encosto.stl
cad/saida/stl/bandeja_mega.stl
cad/saida/stl/bucha_608.stl
cad/saida/stl/calco_solenoide.stl
cad/saida/stl/carro_matriz.stl
cad/saida/stl/carro_puncao.stl
cad/saida/stl/espacador_bucha_curto.stl
cad/saida/stl/espacador_bucha_longo.stl
cad/saida/stl/esticador.stl
cad/saida/stl/guia_papel_dir.stl
cad/saida/stl/guia_papel_esq.stl
cad/saida/stl/mancal_eixo_papel.stl
cad/saida/stl/mancal_superior.stl
cad/saida/stl/manipulo.stl
cad/saida/stl/placa_conectores.stl
cad/saida/stl/pressor_base.stl
cad/saida/stl/pressor_braco.stl
cad/saida/stl/rolete.stl
cad/saida/stl/suporte_fim_de_curso.stl
cad/saida/stl/suporte_modulo.stl
cad/saida/stl/suporte_motor_y.stl
cad/saida/stl/suporte_sensor_papel.stl
cad/saida/stl/torre_motor_x.stl
cad/saida/stl/trava_eixos.stl
