murilo999-666/impressora-braille/docs/imagens/montagem_cima.png

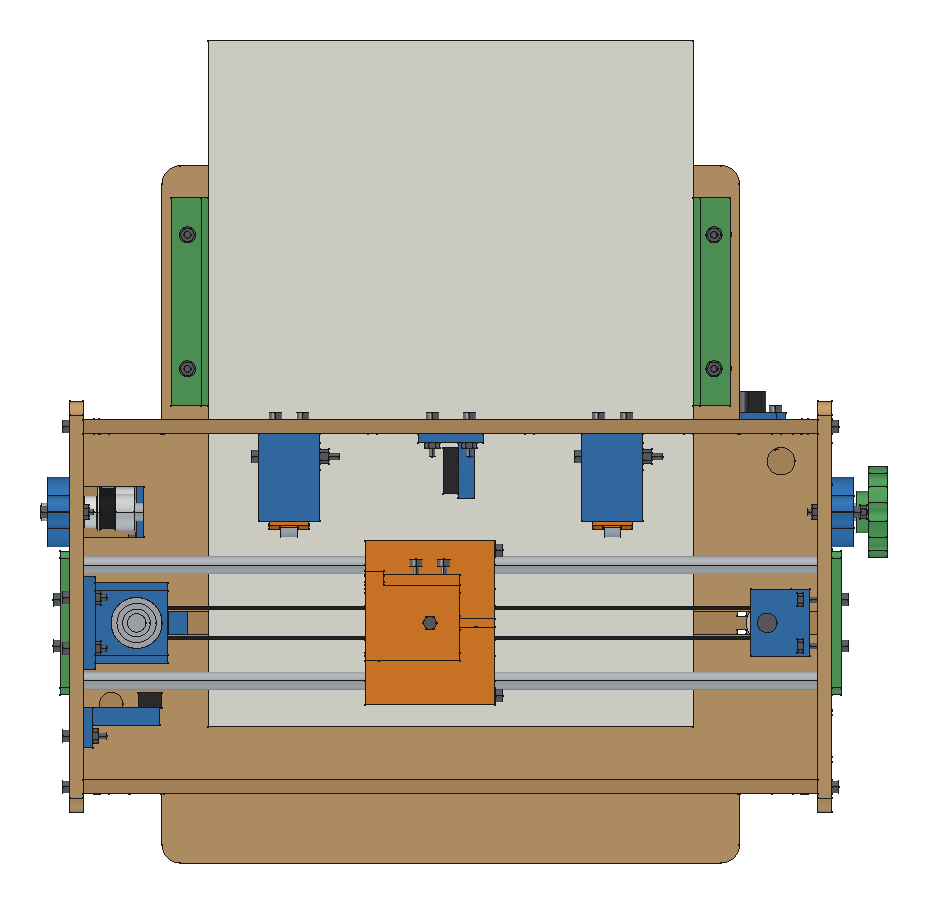
docs/imagens/montagem_cima.png
