murilo999-666/impressora-braille/docs/imagens/montagem_frente.png

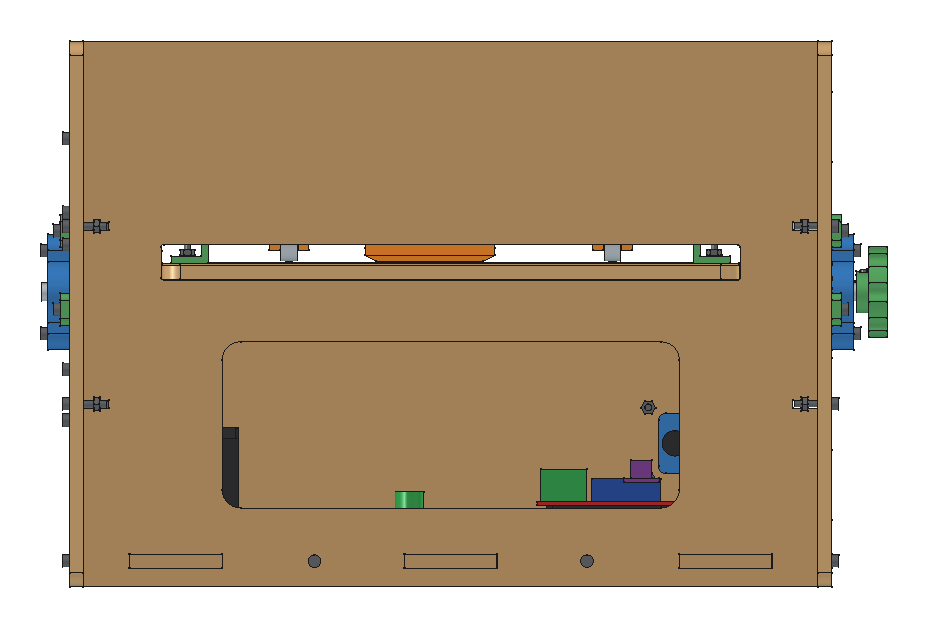
docs/imagens/montagem_frente.png
