murilo999-666/impressora-braille/firmware/ImpressoraBraille/tabela_braille.h

// GERADO por software/gera_tabela_firmware.js a partir de software/braille-pt.js. NAO EDITAR.
// Cela = 6 bits: bit 0 = ponto 1 ... bit 5 = ponto 6. Codigos de caractere em Latin-1 / Unicode < 256.
#ifndef TABELA_BRAILLE_H
#define TABELA_BRAILLE_H
#include <avr/pgmspace.h>

#define CELA_NUMERO 0x3C
#define CELA_MAIUSCULA 0x28
#define CELA_LETRA 0x10
#define CELA_HIFEN 0x24

// letras minusculas: {codigo, cela}
const uint8_t TAB_LETRAS[][2] PROGMEM = {
  {0x61, 0x01},
  {0x62, 0x03},
  {0x63, 0x09},
  {0x64, 0x19},
  {0x65, 0x11},
  {0x66, 0x0B},
  {0x67, 0x1B},
  {0x68, 0x13},
  {0x69, 0x0A},
  {0x6A, 0x1A},
  {0x6B, 0x05},
  {0x6C, 0x07},
  {0x6D, 0x0D},
  {0x6E, 0x1D},
  {0x6F, 0x15},
  {0x70, 0x0F},
  {0x71, 0x1F},
  {0x72, 0x17},
  {0x73, 0x0E},
  {0x74, 0x1E},
  {0x75, 0x25},
  {0x76, 0x27},
  {0x77, 0x3A},
  {0x78, 0x2D},
  {0x79, 0x3D},
  {0x7A, 0x35},
  {0xE0, 0x2B},
  {0xE1, 0x37},
  {0xE2, 0x21},
  {0xE3, 0x1C},
  {0xE4, 0x1C},
  {0xE7, 0x2F},
  {0xE8, 0x2E},
  {0xE9, 0x3F},
  {0xEA, 0x23},
  {0xEB, 0x2B},
  {0xEC, 0x29},
  {0xED, 0x0C},
  {0xEE, 0x29},
  {0xEF, 0x3B},
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
};
const uint8_t N_LETRAS = 50;

// digitos 0..9
const uint8_t TAB_DIGITOS[10] PROGMEM = {0x1A, 0x01, 0x03, 0x09, 0x19, 0x11, 0x0B, 0x1B, 0x13, 0x0A};

// sinais: {codigo, quantidade de celas, cela 1, cela 2, cela 3}
const uint8_t TAB_SINAIS[][5] PROGMEM = {
  {0x21, 1, 0x16, 0x00, 0x00},
  {0x22, 1, 0x26, 0x00, 0x00},
  {0x23, 2, 0x3C, 0x05, 0x00},
  {0x24, 1, 0x30, 0x00, 0x00},
  {0x25, 2, 0x38, 0x34, 0x00},
  {0x26, 1, 0x2F, 0x00, 0x00},
  {0x27, 1, 0x04, 0x00, 0x00},
  {0x28, 2, 0x23, 0x04, 0x00},
  {0x29, 2, 0x20, 0x1C, 0x00},
  {0x2A, 1, 0x14, 0x00, 0x00},
  {0x2B, 1, 0x16, 0x00, 0x00},
  {0x2C, 1, 0x02, 0x00, 0x00},
  {0x2D, 1, 0x24, 0x00, 0x00},
  {0x2E, 1, 0x04, 0x00, 0x00},
  {0x2F, 2, 0x20, 0x02, 0x00},
  {0x3A, 1, 0x12, 0x00, 0x00},
  {0x3B, 1, 0x06, 0x00, 0x00},
  {0x3D, 1, 0x36, 0x00, 0x00},
  {0x3F, 1, 0x22, 0x00, 0x00},
  {0x40, 1, 0x31, 0x00, 0x00},
  {0x5B, 2, 0x37, 0x04, 0x00},
  {0x5D, 2, 0x20, 0x3E, 0x00},
  {0x5F, 2, 0x28, 0x24, 0x00},
  {0xA7, 2, 0x0E, 0x0E, 0x00},
  {0xAB, 1, 0x26, 0x00, 0x00},
  {0xB0, 1, 0x34, 0x00, 0x00},
  {0xBB, 1, 0x26, 0x00, 0x00},
  {0xD7, 1, 0x26, 0x00, 0x00},
  {0xF7, 1, 0x32, 0x00, 0x00}
};
const uint8_t N_SINAIS = 29;

#endif
