murilo999-666/impressora-braille/(commit log)

2026-10-13 CAD paramétrico no FreeCAD: modelo, verificação, STL, STEP, DXF/SVG e mesas de impressão
    Claude-Session: https://claude.ai/code/session_01Nv13rQCVh63es3gfN1P5ZC
    [anel_encosto.step, anel_encosto.stl, bandeja_mega.step, bandeja_mega.stl, base.dxf, bucha_608.step, bucha_608.stl, calco_solenoide.step]
2026-10-13 Esquemas elétricos: ligação geral e circuito do solenoide
    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
2026-10-13 Firmware para Arduino Mega 2560 + RAMPS 1.4
    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
2026-10-13 CAD: relatório de verificação completo (5 situações, 0 interferências)
    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
2026-10-29 Docs: projeto parte dos repositórios da BrailleRAP, sem protótipo antigo
    O texto dizia que o projeto reaproveitava um protótipo antigo da equipe.
    Na verdade os arquivos vieram dos repositórios públicos da BrailleRAP e
    foram melhorados; a eletrônica, os motores e os eixos foram comprados a
    preço de sucata na Lixotec (Foz do Iguaçu). A conta do solenoide de 24 V
    continua, agora como justificativa da alimentação de 24 a 32 V.
    Claude-Session: https://claude.ai/code/session_012FLipKBc45jF31j4NyjhG2
